JonBuhl/Hapticpad/3D Files/STEP/Custom Keycap - Machined.STEP

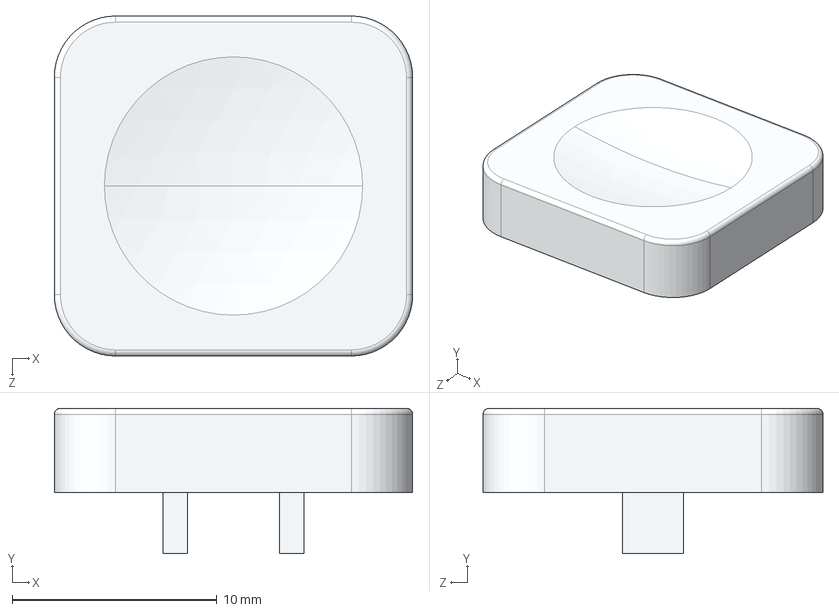
[picture p3: CAD file, 2026-01-09]
3D Files/STEP/Custom Keycap - Machined.STEP
17.5 x 7.10 x 16.6 mm
