JonBuhl/Hapticpad/3D Files/STL's/PCB Spacer.STL

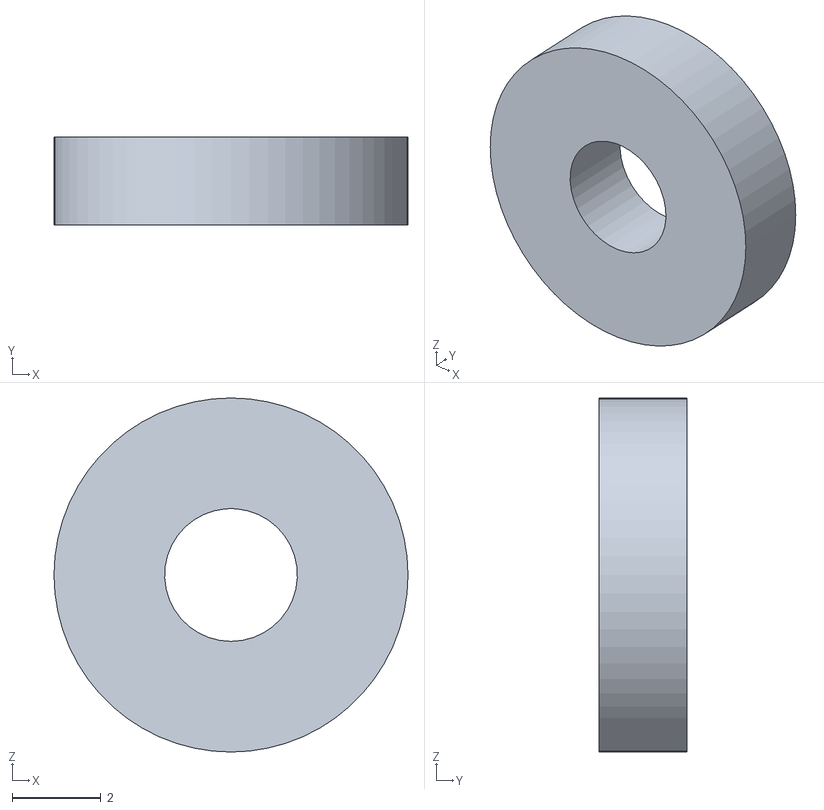
[picture p4: CAD file, 2026-01-09]
3D Files/STL's/PCB Spacer.STL
8.00 x 2.00 x 8.00
