JonBuhl/Hapticpad/3D Files/STEP/Macro Pad Jog Wheel Machined.STEP

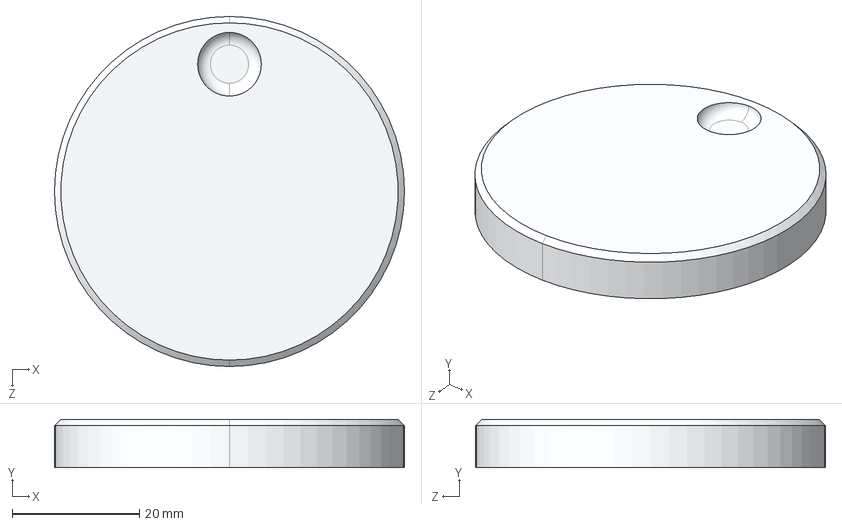
[picture p5: CAD file, 2026-01-09]
3D Files/STEP/Macro Pad Jog Wheel Machined.STEP
55.0 x 7.60 x 55.0 mm
