JonBuhl/Hapticpad/3D Files/STL's/Menu Button Printed.STL

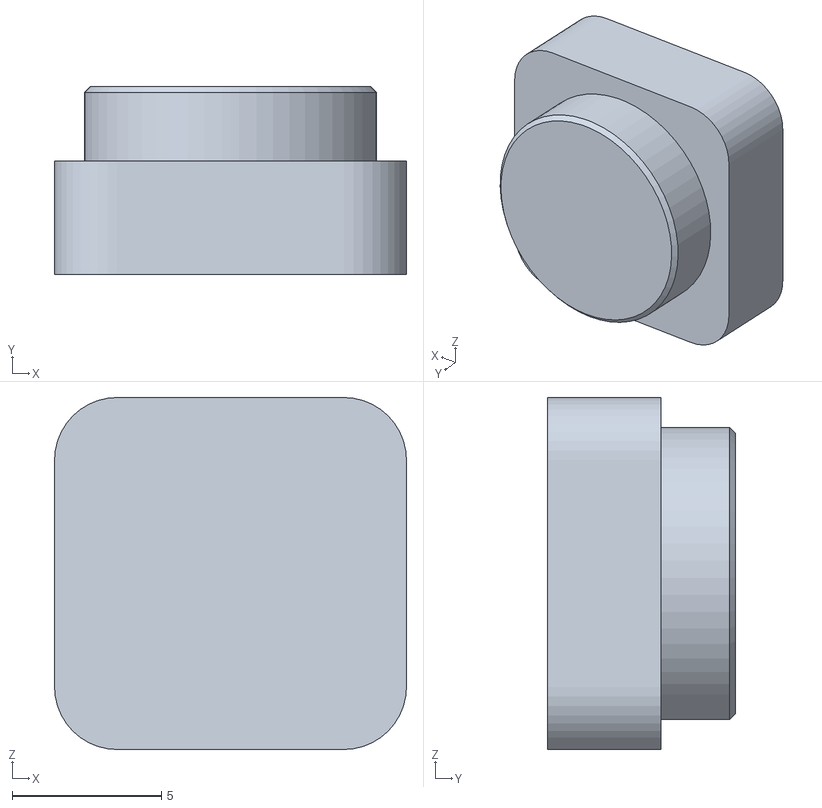
[picture p6: CAD file, 2026-01-09]
3D Files/STL's/Menu Button Printed.STL
11.8 x 6.30 x 11.8
