JonBuhl/Hapticpad/3D Files/STEP/Macro Pad Machined.STEP

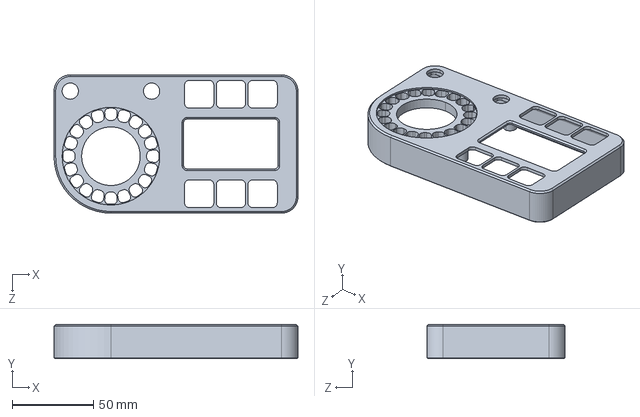
[picture p7: CAD file, 2026-01-09]
3D Files/STEP/Macro Pad Machined.STEP
150.0 x 21.0 x 85.0 mm
