JonBuhl/Hapticpad/3D Files/STL's/Macropad Bottom Cover.STL

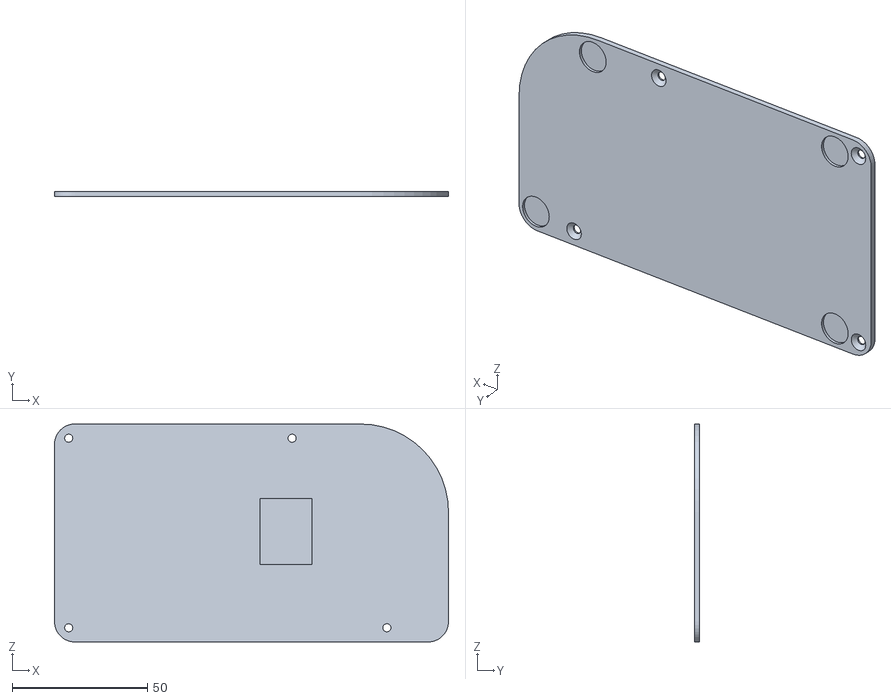
[picture p8: CAD file, 2026-01-09]
3D Files/STL's/Macropad Bottom Cover.STL
145.5 x 2.00 x 80.5
