JonBuhl/Hapticpad/3D Files/STL's/Encoder Mount.STL

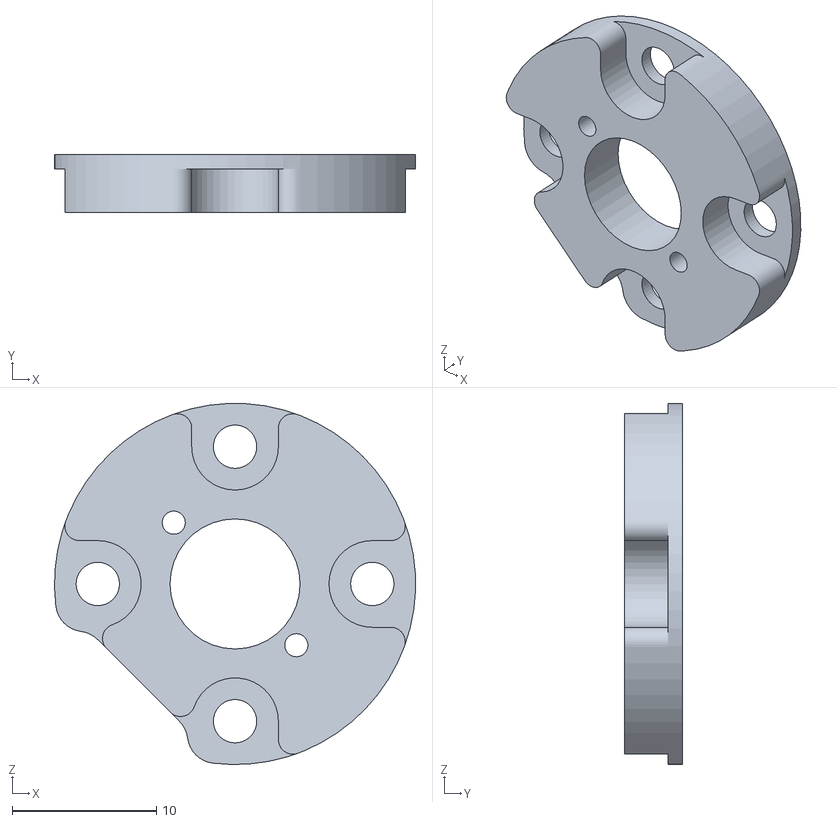
[picture p9: CAD file, 2026-01-09]
3D Files/STL's/Encoder Mount.STL
25.0 x 4.00 x 25.0
