JonBuhl/Hapticpad/3D Files/STL's/Magnet Wheel Mount.STL

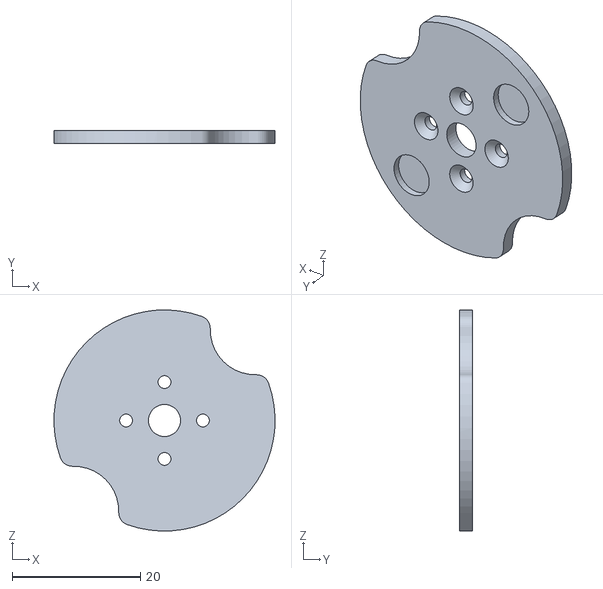
[picture p10: CAD file, 2026-01-09]
3D Files/STL's/Magnet Wheel Mount.STL
34.5 x 2.00 x 34.5
