JonBuhl/Hapticpad/3D Files/STL's/Magnet Holder.STL

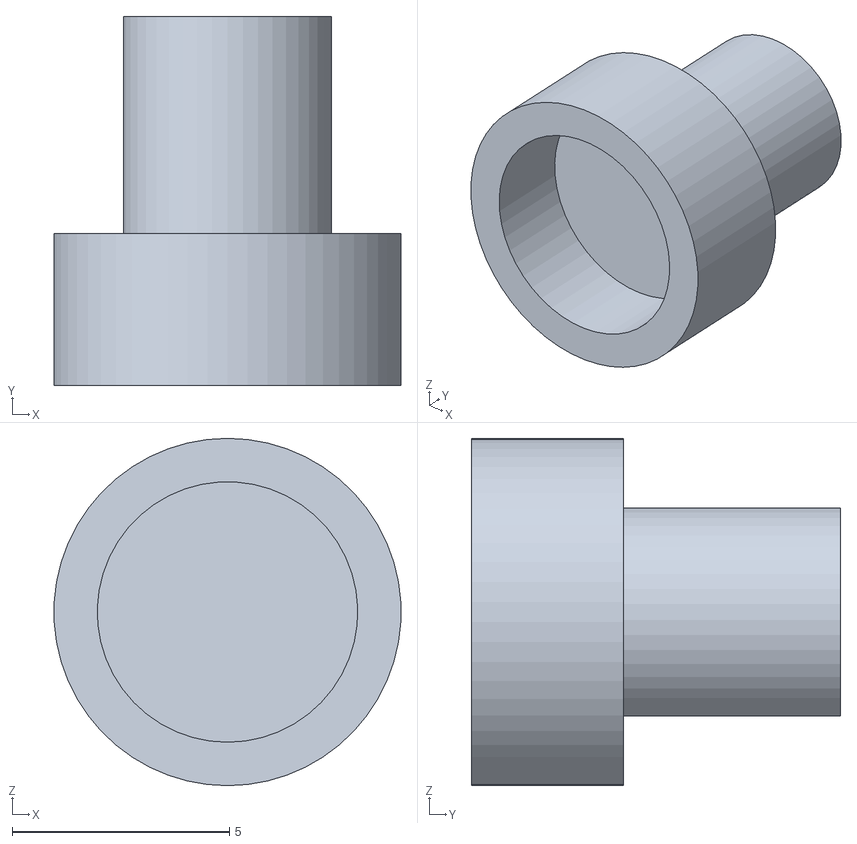
[picture p11: CAD file, 2026-01-09]
3D Files/STL's/Magnet Holder.STL
7.99 x 8.50 x 8.00
