JonBuhl/Hapticpad/3D Files/STL's/Macro Pad Magnetic Jog Wheel.STL

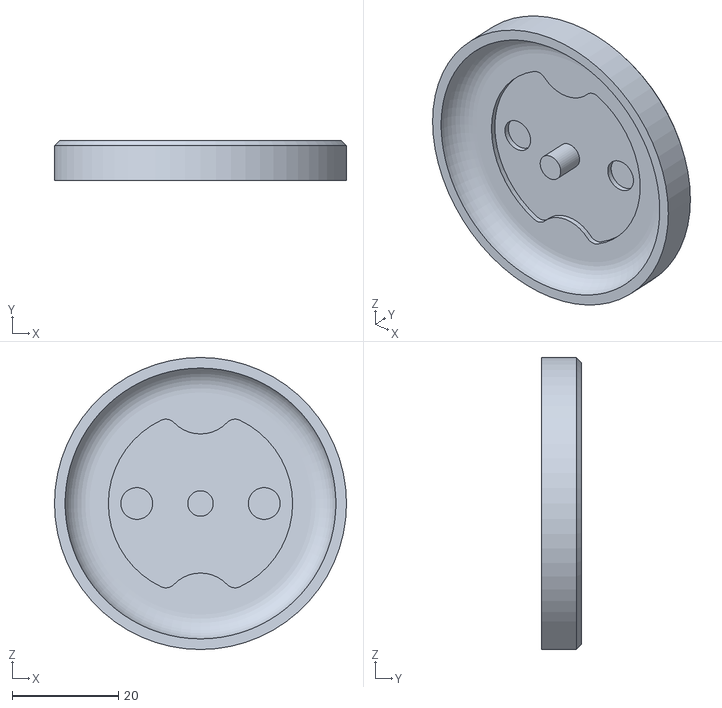
[picture p12: CAD file, 2026-01-09]
3D Files/STL's/Macro Pad Magnetic Jog Wheel.STL
55.0 x 7.60 x 55.0
