JonBuhl/Hapticpad/3D Files/STL's/LED Diffuser Ring.STL

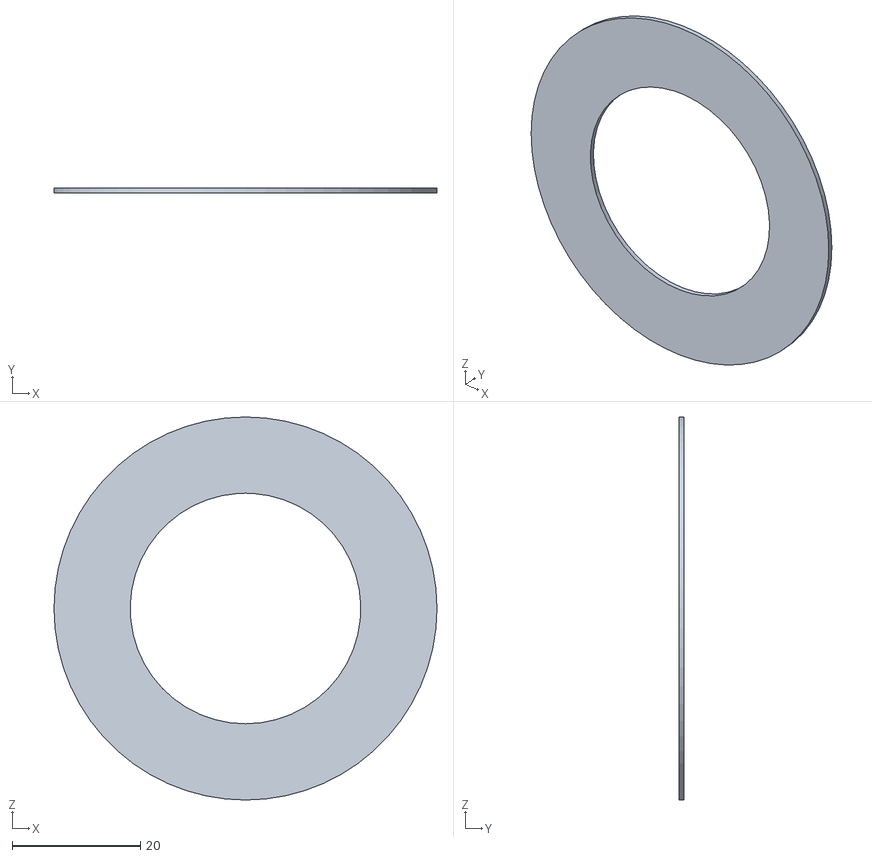
[picture p13: CAD file, 2026-01-09]
3D Files/STL's/LED Diffuser Ring.STL
59.8 x 0.8 x 59.8
