JonBuhl/Hapticpad/(list of files, cad)

Other CAD files:
3D Files/STEP/Menu Button - Machined.STEP
3D Files/STL's/Custom Keycap.STL
3D Files/STL's/Macro Pad - Printed Version.STL
