JonBuhl/Hapticpad/3D Files/STEP/Macro Pad Housing.pdf

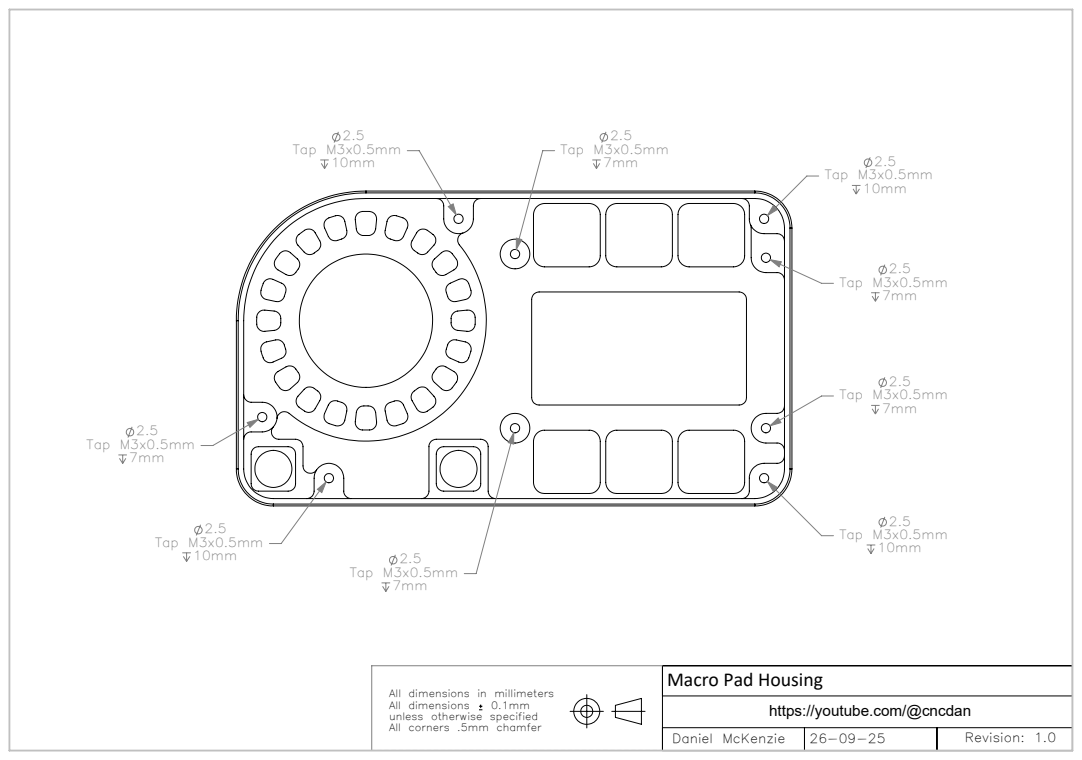
[picture p14: page 1]
Tap M3x0.5mm; Daniel McKenzie; Revision: 1.0; All dimensions

Macro Pad Housing

All dimensions in millimeters
unless otherwise specified
All corners .5mm chamfer

https://youtube.com/@cncdan
