JonBuhl/Hapticpad/PCB's/MacroPad Controller Board/MacroPad Controller Board.kicad_pcb

## KiCad design PCB's/MacroPad Controller Board/MacroPad Controller Board.kicad_pcb (2026-01-10)

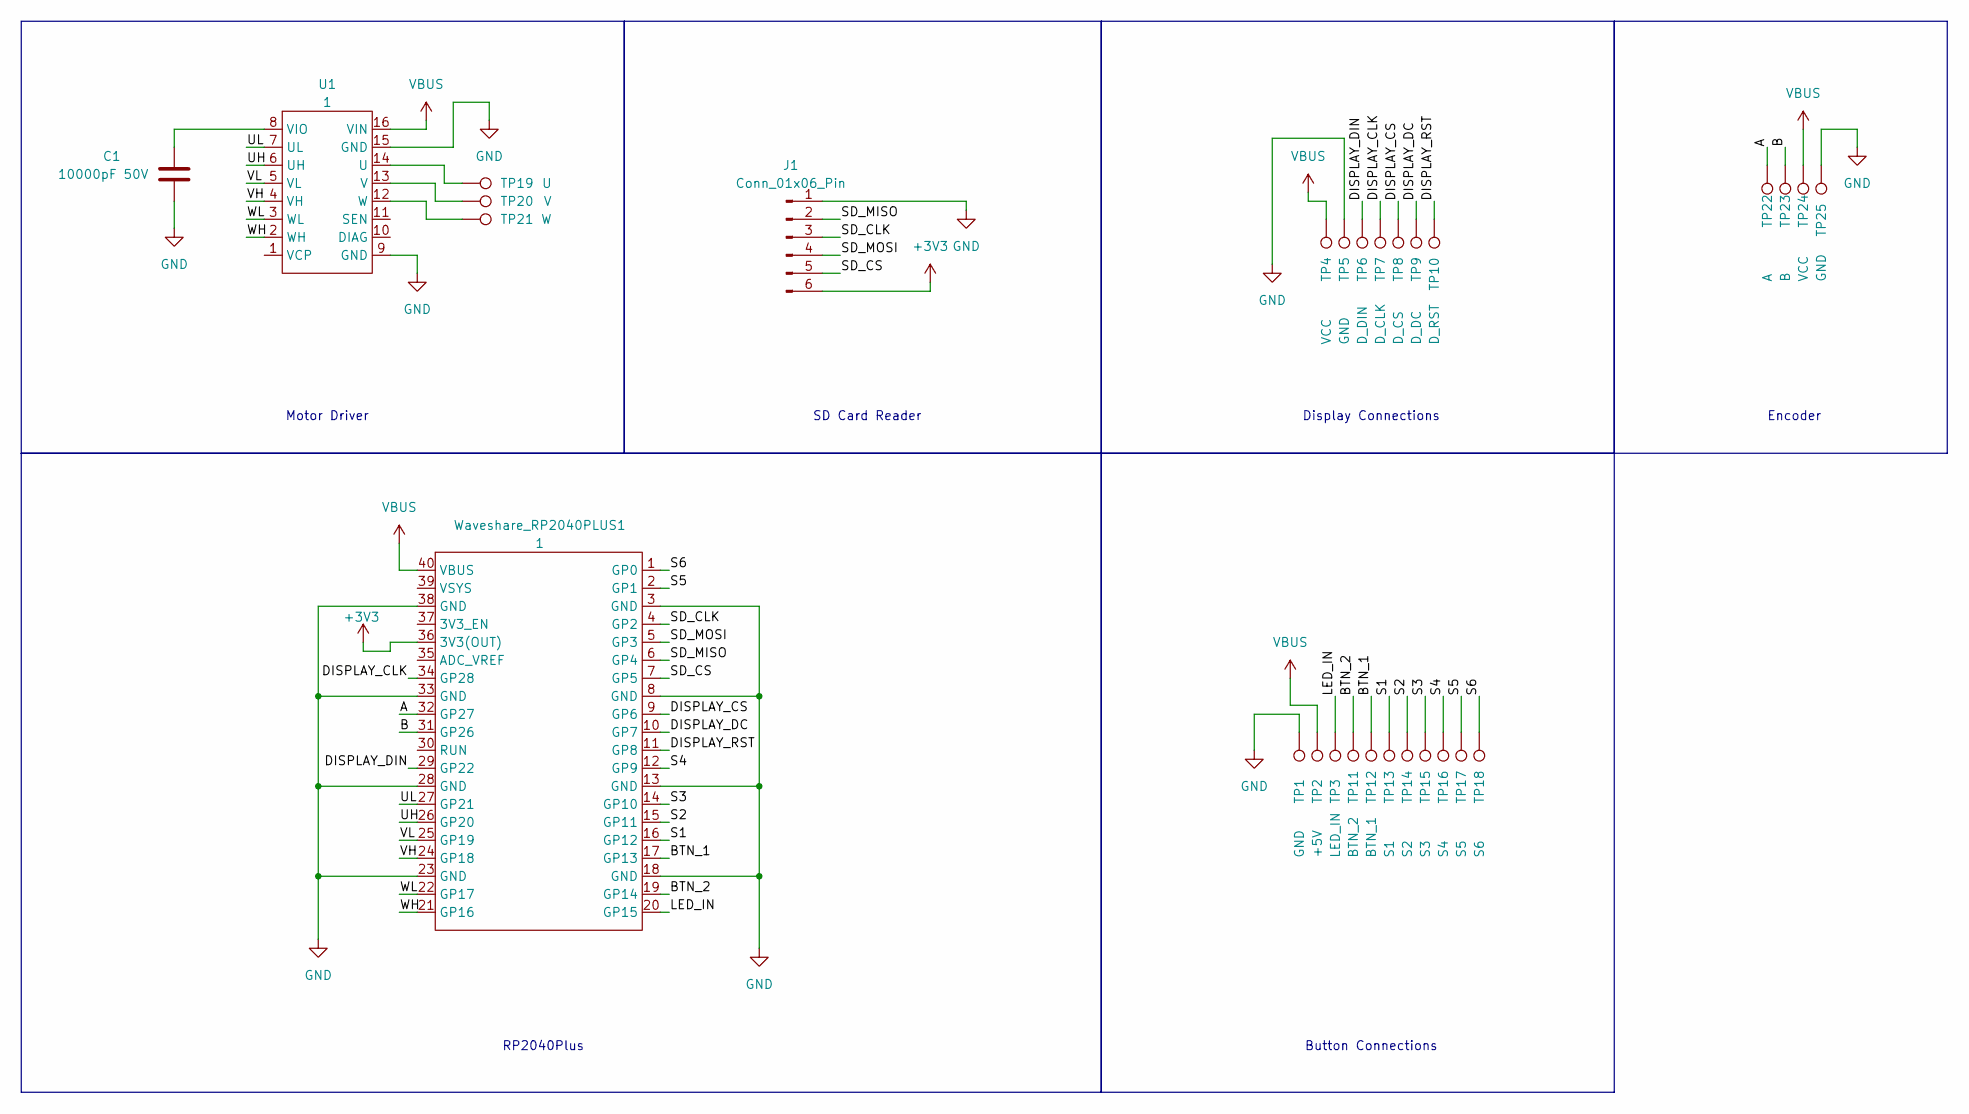
[picture p15: schematic MacroPad Controller Board.kicad_sch]

Parts:
C1: 10000pF 50V; C_0603_1608Metric_Pad1.08x0.95mm_HandSolder
J1: Conn_01x06_Pin; PinHeader_1x06_P2.54mm_Vertical
TP1, TP5, TP25: GND; TestPoint_THTPad_D1.0mm_Drill0.5mm
TP2: +5V; TestPoint_THTPad_D1.0mm_Drill0.5mm
TP3: LED_IN; TestPoint_THTPad_D1.0mm_Drill0.5mm
TP4, TP24: VCC; TestPoint_THTPad_D1.0mm_Drill0.5mm
TP6: D_DIN; TestPoint_THTPad_D1.0mm_Drill0.5mm
TP7: D_CLK; TestPoint_THTPad_D1.0mm_Drill0.5mm
TP8: D_CS; TestPoint_THTPad_D1.0mm_Drill0.5mm
TP9: D_DC; TestPoint_THTPad_D1.0mm_Drill0.5mm
TP10: D_RST; TestPoint_THTPad_D1.0mm_Drill0.5mm
TP11: BTN_2; TestPoint_THTPad_D1.0mm_Drill0.5mm
TP12: BTN_1; TestPoint_THTPad_D1.0mm_Drill0.5mm
TP13: S1; TestPoint_THTPad_D1.0mm_Drill0.5mm
TP14: S2; TestPoint_THTPad_D1.0mm_Drill0.5mm
TP15: S3; TestPoint_THTPad_D1.0mm_Drill0.5mm
TP16: S4; TestPoint_THTPad_D1.0mm_Drill0.5mm
TP17: S5; TestPoint_THTPad_D1.0mm_Drill0.5mm
TP18: S6; TestPoint_THTPad_D1.0mm_Drill0.5mm
TP19: U; TestPoint_THTPad_D2.0mm_Drill1.0mm
TP20: V; TestPoint_THTPad_D2.0mm_Drill1.0mm
TP21: W; TestPoint_THTPad_D2.0mm_Drill1.0mm
TP22: A; TestPoint_THTPad_D1.0mm_Drill0.5mm
TP23: B; TestPoint_THTPad_D1.0mm_Drill0.5mm
U1: 1; Sparkfun_TMC6300
Waveshare_RP2040PLUS1: 1; RP2040PLUS_SMD

Connections:
+3V3: J1.6, Waveshare_RP2040PLUS1.36 (3V3(OUT)); also elsewhere on the board
/A: TP22.1, Waveshare_RP2040PLUS1.32 (GP27); also elsewhere on the board
/B: TP23.1, Waveshare_RP2040PLUS1.31 (GP26); also elsewhere on the board
/BTN_1: TP12.1, Waveshare_RP2040PLUS1.17 (GP13); also elsewhere on the board
/BTN_2: TP11.1, Waveshare_RP2040PLUS1.19 (GP14); also elsewhere on the board
/DISPLAY_CLK: TP7.1, Waveshare_RP2040PLUS1.34 (GP28); also elsewhere on the board
/DISPLAY_CS: TP8.1, Waveshare_RP2040PLUS1.9 (GP6); also elsewhere on the board
/DISPLAY_DC: TP9.1, Waveshare_RP2040PLUS1.10 (GP7); also elsewhere on the board
/DISPLAY_DIN: TP6.1, Waveshare_RP2040PLUS1.29 (GP22); also elsewhere on the board
/DISPLAY_RST: TP10.1, Waveshare_RP2040PLUS1.11 (GP8); also elsewhere on the board
/LED_IN: TP3.1, Waveshare_RP2040PLUS1.20 (GP15); also elsewhere on the board
/S1: TP13.1, Waveshare_RP2040PLUS1.16 (GP12); also elsewhere on the board
/S2: TP14.1, Waveshare_RP2040PLUS1.15 (GP11); also elsewhere on the board
/S3: TP15.1, Waveshare_RP2040PLUS1.14 (GP10); also elsewhere on the board
/S4: TP16.1, Waveshare_RP2040PLUS1.12 (GP9); also elsewhere on the board
/S5: TP17.1, Waveshare_RP2040PLUS1.2 (GP1); also elsewhere on the board
/S6: TP18.1, Waveshare_RP2040PLUS1.1 (GP0); also elsewhere on the board
/SD_CLK: J1.3, Waveshare_RP2040PLUS1.4 (GP2); also elsewhere on the board
/SD_CS: J1.5, Waveshare_RP2040PLUS1.7 (GP5); also elsewhere on the board
/SD_MISO: J1.2, Waveshare_RP2040PLUS1.6 (GP4); also elsewhere on the board
/SD_MOSI: J1.4, Waveshare_RP2040PLUS1.5 (GP3); also elsewhere on the board
/UH: U1.6 (UH), Waveshare_RP2040PLUS1.26 (GP20); also elsewhere on the board
/UL: U1.7 (UL), Waveshare_RP2040PLUS1.27 (GP21); also elsewhere on the board
/VH: U1.4 (VH), Waveshare_RP2040PLUS1.24 (GP18); also elsewhere on the board
/VL: U1.5 (VL), Waveshare_RP2040PLUS1.25 (GP19); also elsewhere on the board
/WH: U1.2 (WH), Waveshare_RP2040PLUS1.21 (GP16); also elsewhere on the board
/WL: U1.3 (WL), Waveshare_RP2040PLUS1.22 (GP17); also elsewhere on the board
GND: C1.2, J1.1, TP1.1, TP5.1, TP25.1, U1.9 (GND), U1.15 (GND), Waveshare_RP2040PLUS1.3 (GND), Waveshare_RP2040PLUS1.8 (GND), Waveshare_RP2040PLUS1.13 (GND), Waveshare_RP2040PLUS1.18 (GND), Waveshare_RP2040PLUS1.23 (GND), Waveshare_RP2040PLUS1.28 (GND), Waveshare_RP2040PLUS1.33 (GND), Waveshare_RP2040PLUS1.38 (GND); also elsewhere on the board
unnamed: TP19.1, U1.14 (U)
unnamed: TP20.1, U1.13 (V)
unnamed: C1.1, U1.8 (VIO)
unnamed: TP21.1, U1.12 (W)
VBUS: TP2.1, TP4.1, TP24.1, U1.16 (VIN), Waveshare_RP2040PLUS1.40 (VBUS); also elsewhere on the board

Notes on the sheet:
Motor Driver
SD Card Reader
RP2040Plus
Display Connections
Button Connections
Encoder

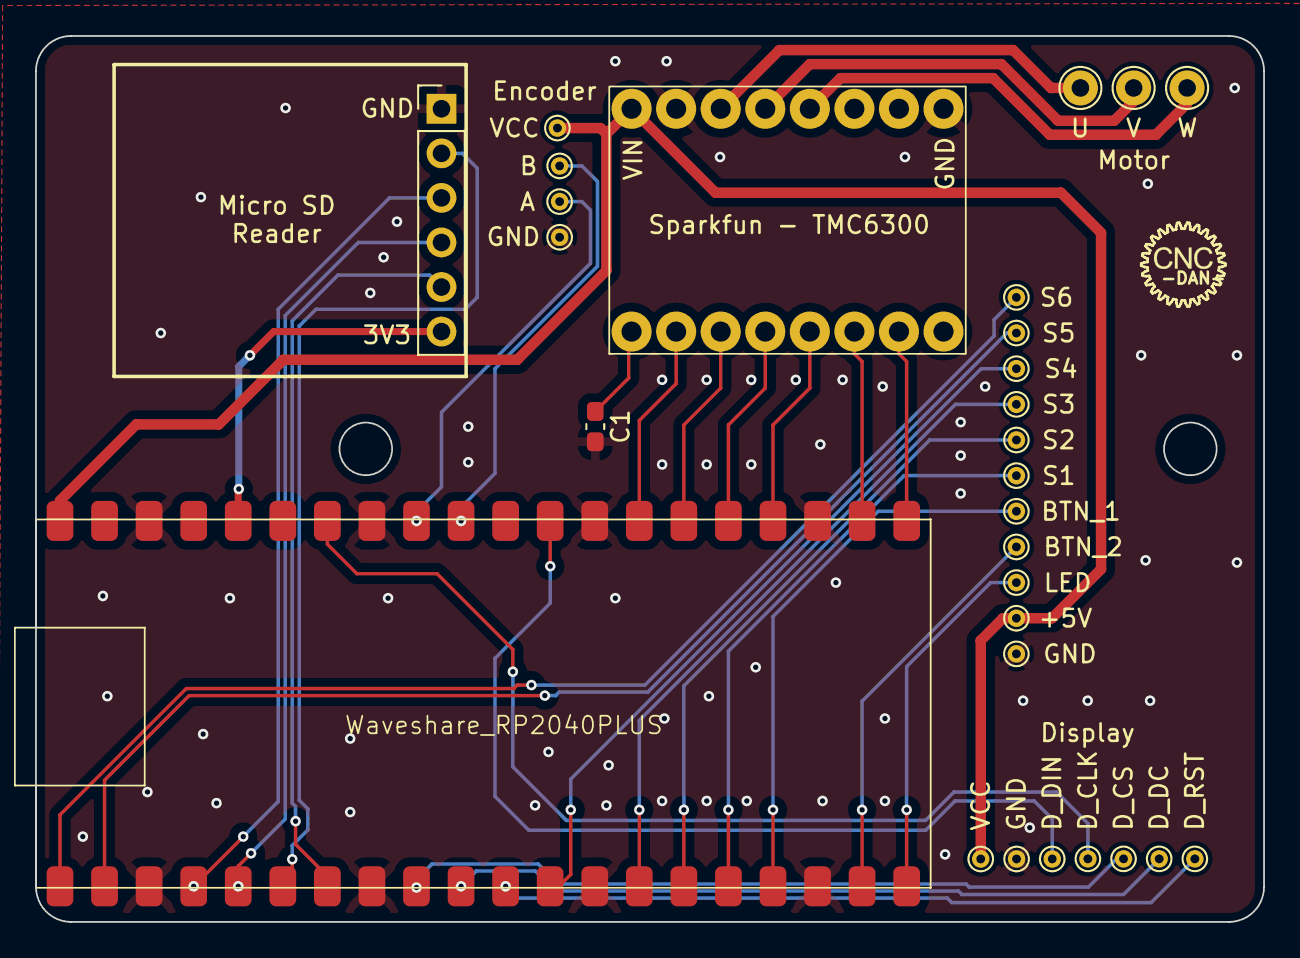
[picture p16: board MacroPad Controller Board.kicad_pcb from above]

Board: 2 copper layers, 70.0 x 50.5 mm, 29 parts (0 on the bottom side), 33 nets.

Other parts of the board:
Waveshare_RP2040PLUS: 1; RP2040PLUS_SMD

Their connections:
+3V3: Waveshare_RP2040PLUS.36 (3V3(OUT)); also elsewhere on the board
/A: Waveshare_RP2040PLUS.32 (GP27); also elsewhere on the board
/B: Waveshare_RP2040PLUS.31 (GP26); also elsewhere on the board
/BTN_1: Waveshare_RP2040PLUS.17 (GP13); also elsewhere on the board
/BTN_2: Waveshare_RP2040PLUS.19 (GP14); also elsewhere on the board
/DISPLAY_CLK: Waveshare_RP2040PLUS.34 (GP28); also elsewhere on the board
/DISPLAY_CS: Waveshare_RP2040PLUS.9 (GP6); also elsewhere on the board
/DISPLAY_DC: Waveshare_RP2040PLUS.10 (GP7); also elsewhere on the board
/DISPLAY_DIN: Waveshare_RP2040PLUS.29 (GP22); also elsewhere on the board
/DISPLAY_RST: Waveshare_RP2040PLUS.11 (GP8); also elsewhere on the board
/LED_IN: Waveshare_RP2040PLUS.20 (GP15); also elsewhere on the board
/S1: Waveshare_RP2040PLUS.16 (GP12); also elsewhere on the board
/S2: Waveshare_RP2040PLUS.15 (GP11); also elsewhere on the board
/S3: Waveshare_RP2040PLUS.14 (GP10); also elsewhere on the board
/S4: Waveshare_RP2040PLUS.12 (GP9); also elsewhere on the board
/S5: Waveshare_RP2040PLUS.2 (GP1); also elsewhere on the board
/S6: Waveshare_RP2040PLUS.1 (GP0); also elsewhere on the board
/SD_CLK: Waveshare_RP2040PLUS.4 (GP2); also elsewhere on the board
/SD_CS: Waveshare_RP2040PLUS.7 (GP5); also elsewhere on the board
/SD_MISO: Waveshare_RP2040PLUS.6 (GP4); also elsewhere on the board
/SD_MOSI: Waveshare_RP2040PLUS.5 (GP3); also elsewhere on the board
/UH: Waveshare_RP2040PLUS.26 (GP20); also elsewhere on the board
/UL: Waveshare_RP2040PLUS.27 (GP21); also elsewhere on the board
/VH: Waveshare_RP2040PLUS.24 (GP18); also elsewhere on the board
/VL: Waveshare_RP2040PLUS.25 (GP19); also elsewhere on the board
/WH: Waveshare_RP2040PLUS.21 (GP16); also elsewhere on the board
/WL: Waveshare_RP2040PLUS.22 (GP17); also elsewhere on the board
GND: Waveshare_RP2040PLUS.3 (GND), Waveshare_RP2040PLUS.8 (GND), Waveshare_RP2040PLUS.13 (GND), Waveshare_RP2040PLUS.18 (GND), Waveshare_RP2040PLUS.23 (GND), Waveshare_RP2040PLUS.28 (GND), Waveshare_RP2040PLUS.33 (GND), Waveshare_RP2040PLUS.38 (GND); also elsewhere on the board
VBUS: Waveshare_RP2040PLUS.40 (VBUS); also elsewhere on the board
