JonBuhl/Hapticpad/PCB's/MacroPad/MacroPad.kicad_pcb

## KiCad design PCB's/MacroPad/MacroPad.kicad_pcb (2026-01-10)

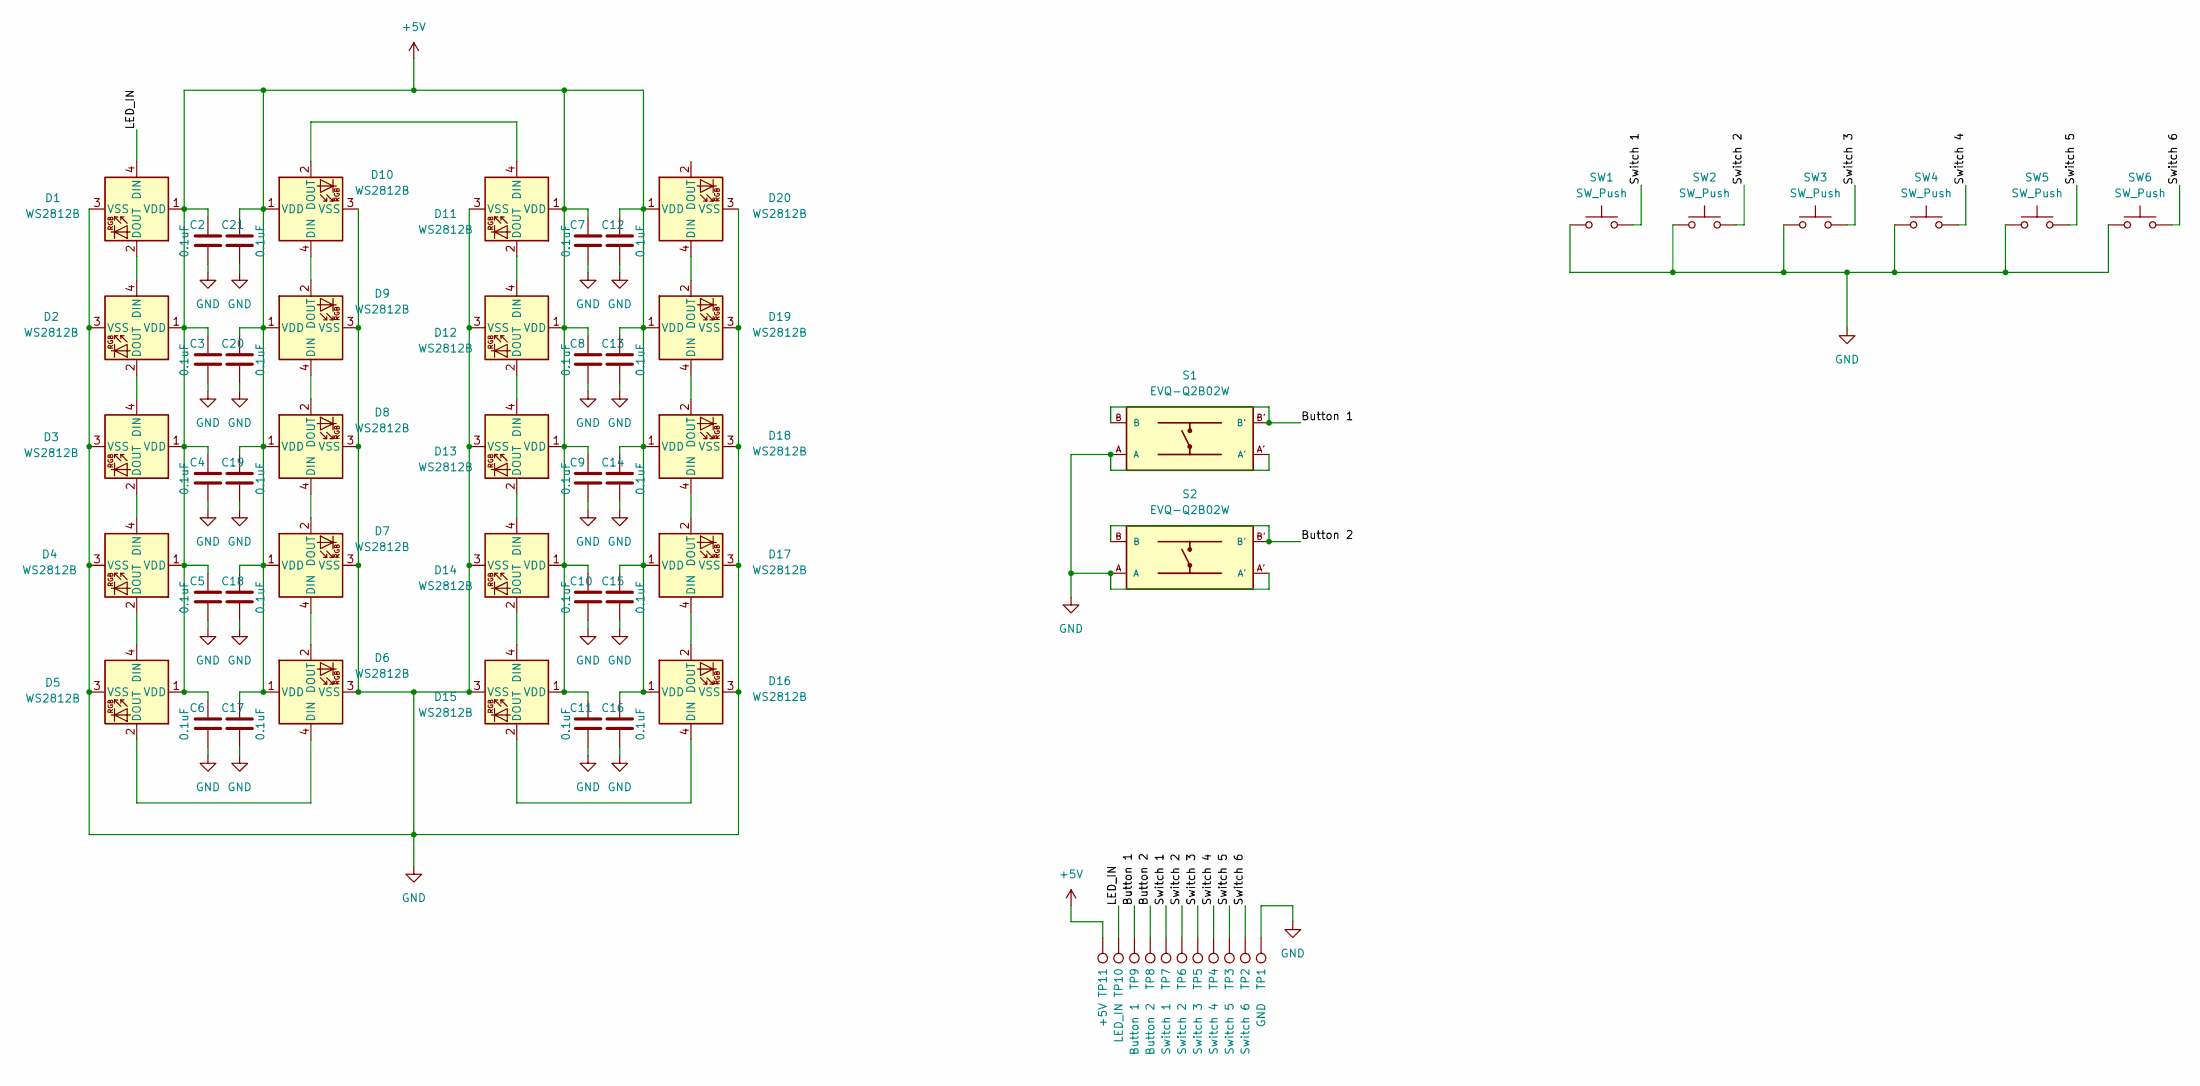
[picture p17: schematic MacroPad.kicad_sch]

Parts:
C2, C3, C4, C5, C6, C7, C8, C9, C10, C11, C12, C13, C14, C15, C16, C17, C18, C19, C20, C21: 0.1uF; C_0603_1608Metric
D1, D2, D3, D4, D5, D6, D7, D8, D9, D10, D11, D12, D13, D14, D15, D16, D17, D18, D19, D20: WS2812B; LED_WS2812B_PLCC4_5.0x5.0mm_P3.2mm
S1, S2: EVQ-Q2B02W; SW_EVQ-Q2B02W
SW1, SW2, SW3, SW4, SW5, SW6: SW_Push; SW_PG1350_reversible
TP1: GND; TestPoint_THTPad_D1.0mm_Drill0.5mm
TP2: Switch 6; TestPoint_THTPad_D1.0mm_Drill0.5mm
TP3: Switch 5; TestPoint_THTPad_D1.0mm_Drill0.5mm
TP4: Switch 4; TestPoint_THTPad_D1.0mm_Drill0.5mm
TP5: Switch 3; TestPoint_THTPad_D1.0mm_Drill0.5mm
TP6: Switch 2; TestPoint_THTPad_D1.0mm_Drill0.5mm
TP7: Switch 1; TestPoint_THTPad_D1.0mm_Drill0.5mm
TP8: Button 2; TestPoint_THTPad_D1.0mm_Drill0.5mm
TP9: Button 1; TestPoint_THTPad_D1.0mm_Drill0.5mm
TP10: LED_IN; TestPoint_THTPad_D1.0mm_Drill0.5mm
TP11: +5V; TestPoint_THTPad_D1.0mm_Drill0.5mm

Connections:
+5V: C2.1, C3.1, C4.1, C5.1, C6.1, C7.1, C8.1, C9.1, C10.1, C11.1, C12.1, C13.1, C14.1, C15.1, C16.1, C17.1, C18.1, C19.1, C20.1, C21.1, D1.1 (VDD), D2.1 (VDD), D3.1 (VDD), D4.1 (VDD), D5.1 (VDD), D6.1 (VDD), D7.1 (VDD), D8.1 (VDD), D9.1 (VDD), D10.1 (VDD), D11.1 (VDD), D12.1 (VDD), D13.1 (VDD), D14.1 (VDD), D15.1 (VDD), D16.1 (VDD), D17.1 (VDD), D18.1 (VDD), D19.1 (VDD), D20.1 (VDD), TP11.1
/Button 1: S1.B, S1.B', TP9.1
/Button 2: S2.B, S2.B', TP8.1
/LED_IN: D1.4 (DIN), TP10.1
/Switch 1: SW1.2, TP7.1
/Switch 2: SW2.2, TP6.1
/Switch 3: SW3.2, TP5.1
/Switch 4: SW4.2, TP4.1
/Switch 5: SW5.2, TP3.1
/Switch 6: SW6.2, TP2.1
GND: C2.2, C3.2, C4.2, C5.2, C6.2, C7.2, C8.2, C9.2, C10.2, C11.2, C12.2, C13.2, C14.2, C15.2, C16.2, C17.2, C18.2, C19.2, C20.2, C21.2, D1.3 (VSS), D2.3 (VSS), D3.3 (VSS), D4.3 (VSS), D5.3 (VSS), D6.3 (VSS), D7.3 (VSS), D8.3 (VSS), D9.3 (VSS), D10.3 (VSS), D11.3 (VSS), D12.3 (VSS), D13.3 (VSS), D14.3 (VSS), D15.3 (VSS), D16.3 (VSS), D17.3 (VSS), D18.3 (VSS), D19.3 (VSS), D20.3 (VSS), S1.A, S1.A', S2.A, S2.A', SW1.1, SW2.1, SW3.1, SW4.1, SW5.1, SW6.1, TP1.1
unnamed: D1.2 (DOUT), D2.4 (DIN)
unnamed: D2.2 (DOUT), D3.4 (DIN)
unnamed: D3.2 (DOUT), D4.4 (DIN)
unnamed: D4.2 (DOUT), D5.4 (DIN)
unnamed: D5.2 (DOUT), D6.4 (DIN)
unnamed: D6.2 (DOUT), D7.4 (DIN)
unnamed: D7.2 (DOUT), D8.4 (DIN)
unnamed: D8.2 (DOUT), D9.4 (DIN)
unnamed: D9.2 (DOUT), D10.4 (DIN)
unnamed: D10.2 (DOUT), D11.4 (DIN)
unnamed: D11.2 (DOUT), D12.4 (DIN)
unnamed: D12.2 (DOUT), D13.4 (DIN)
unnamed: D13.2 (DOUT), D14.4 (DIN)
unnamed: D14.2 (DOUT), D15.4 (DIN)
unnamed: D15.2 (DOUT), D16.4 (DIN)
unnamed: D16.2 (DOUT), D17.4 (DIN)
unnamed: D17.2 (DOUT), D18.4 (DIN)
unnamed: D18.2 (DOUT), D19.4 (DIN)
unnamed: D19.2 (DOUT), D20.4 (DIN)

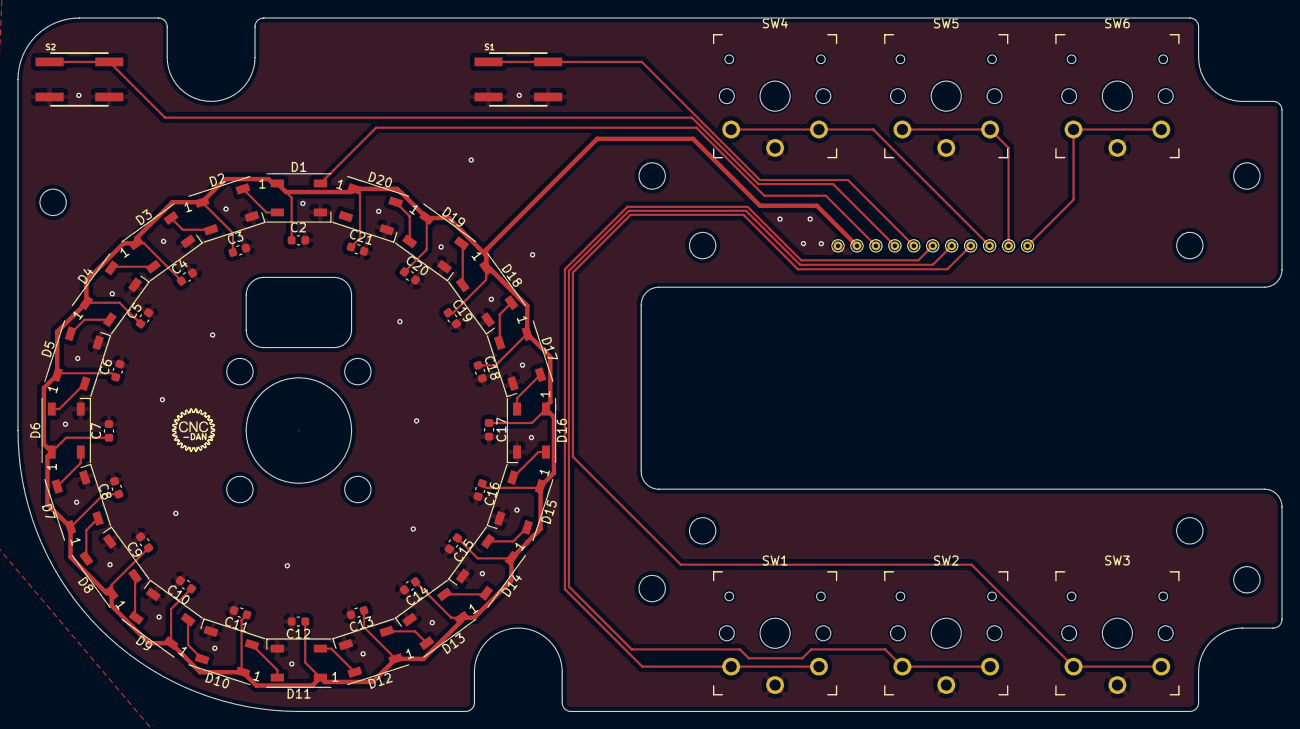
[picture p18: board MacroPad.kicad_pcb from above]

Board: 2 copper layers, 144.0 x 79.0 mm, 59 parts (0 on the bottom side), 30 nets.
