JonBuhl/Hapticpad/Software/MacroPad/MacroPad.ino

#include <Arduino.h>
#include <U8g2lib.h>
#include <SimpleFOC.h>
#include <Adafruit_TinyUSB.h>
#include <SdFat.h>
#include <SPI.h>
#include <SD.h>
#include <FastLED.h>
#include "menu.h"
#include "haptics.h"

const unsigned char SD_Card [] PROGMEM = {
	0xff, 0x01, 0x55, 0x01, 0x55, 0x01, 0xff, 0x01, 0x01, 0x03, 0x2d, 0x02, 0x45, 0x03, 0x49, 0x01, 
	0x2d, 0x03, 0x01, 0x02, 0xfd, 0x02, 0x01, 0x02, 0xff, 0x03
};

#ifdef U8X8_HAVE_HW_I2C
#include <Wire.h>
#endif

// Wheel mode ids and the haptic model live in haptics.h

#define KEY_LEFT_CTRL 17

#define NUM_LEDS 20
#define DATA_PIN 15

CRGB leds[NUM_LEDS];

//User Configurable LED Settings
byte primaryColour[3] = {0,50,50}; //Red, Green, Blue
byte secondaryColour[3] = {0,0,0};
int ledBrightness = 100;
int ledSpeed = 50;

//LED Sequence Variables
float redScale;
float greenScale;
float blueScale;
int sequenceStep = 0;
int ledMode = 3;
unsigned long ledTimer;

const uint8_t LED_MODE_COUNT = 6;
const char *ledModeNames[LED_MODE_COUNT] = {"Halo", "Breath", "Bands", "Rainbow", "Solid", "Off"};
uint8_t ledModeMenu[LED_MODE_COUNT] = {0, 1, 2, 3, 4, 5};
uint8_t ledModeMenuCount = LED_MODE_COUNT;
uint8_t rgbMenuSelection = 3;
uint8_t colorMenuSelection = 0;
uint8_t colorEditSelection = 0;
uint8_t colorEditChannel = 0; //0=R,1=G,2=B
bool colorEditActive = false;
uint8_t *colorEditPtr = nullptr;
bool colorDirty = false;

int8_t ledModeIndex(const char *mode) {
  if (strcmp(mode, "Halo") == 0) return 0;
  if (strcmp(mode, "Breath") == 0) return 1;
  if (strcmp(mode, "Bands") == 0) return 2;
  if (strcmp(mode, "Rainbow") == 0) return 3;
  if (strcmp(mode, "Solid") == 0) return 4;
  if (strcmp(mode, "Off") == 0) return 5;
  return -1;
}

const char *ledModeToString(uint8_t mode) {
  if (mode < LED_MODE_COUNT) {
    return ledModeNames[mode];
  }
  return "";
}

uint8_t findLedMenuIndex(uint8_t mode){
  for(uint8_t i = 0; i < ledModeMenuCount; i++){
    if(ledModeMenu[i] == mode){
      return i;
    }
  }
  return 0;
}

//LED Halo Variables
int haloCount = 0; //Which is the brightest LED in the sequence

//LED Breath Variables
bool breathIncrease = true;

//LED Bands
bool evenNumber = false;
int loopCounter;

bool debug = false;

//SD Pins
const int _MISO = 4;
const int _MOSI = 3;
const int _CS = 5;
const int _SCK = 2;

bool sdDetected = false;

Adafruit_USBD_MSC usb_msc;
SdFat usbStorageFat;
SdSpiConfig usbStorageConfig(_CS, DEDICATED_SPI, SD_SCK_MHZ(12), &SPI);
uint32_t usbStorageBlockCount = 0;
bool usbStorageMode = false;
unsigned long usbStorageButtonTimer = 0;

U8G2_SSD1309_128X64_NONAME0_1_4W_SW_SPI u8g2(U8G2_R0, 28, 22, 6, 7, 8);

BLDCMotor motor = BLDCMotor(7);
BLDCDriver6PWM driver = BLDCDriver6PWM(20, 21, 18,19, 16, 17);

//float target_velocity = 6;
Commander command = Commander(Serial);

Encoder encoder = Encoder(27, 26, 1024);
void doA(){encoder.handleA();}
void doB(){encoder.handleB();}

// angle set point variable
float target_angle = 0; //Radians. 1 Rad = 57.2958 Deg
float new_target_angle;

float target_velocity = 0;
float last_velocity = 0;
float testFactor;

float angle_step = radians(360/40);
float encoderAngle;
float lastEncoderAngle;
bool keyPressed = false;
bool wheelKeyPressed = false;

//PID Values

float Clicky_P = 0.5;    //legacy, Clicky now uses the haptic model
float Clicky_I = 0;      //legacy
float Twist_P = 0.65;    //legacy, Twist now uses the haptic model
float Twist_I = 0.2;     //legacy
float Momentum_P = 0.3;
float Momentum_I = 0;
float motorP = 0.5;
float motorI = 0;
float motorD = 0;

long timer;
long aceltimer;
long mouseTimer;
float interval;
unsigned long wheelKeyTimer;
unsigned long keyTimer;

long debounceTimer;
bool decelDetected = false;
bool decelerating = false;

// wheelMode and wheelModeChanged are written on core 1 (profile/settings load,
// opening and closing the menu) and read on core 0 in loop(). Without volatile
// the compiler is free to hoist the load out of the main loop, which leaves core
// 0 running whichever mode it saw first and never noticing the menu.
volatile int wheelMode = 0;
int lastWheelMode = -1; //core 0 only
volatile bool wheelModeChanged = true;

// ---- Wheel domains ----
// A macro button that carries a <WheelMode> of its own replaces what the wheel
// does while it is selected, instead of sending a macro. wheelMode above always
// holds whatever is currently driving the wheel; these two keep the profile's
// own settings so we can fall back to them, and so lastState never records a
// domain mode.
uint8_t profileWheelMode = 0;
uint8_t profileWheelKey = 0;
// Per button domain settings, WHEEL_DOMAIN_NONE = ordinary macro button. Note
// that WHEEL_DOMAIN_NONE is not zero, so these cannot be left to zero init or
// every button would look like a Clicky domain until a profile is loaded.
uint8_t buttonWheelMode[6] = {
  WHEEL_DOMAIN_NONE, WHEEL_DOMAIN_NONE, WHEEL_DOMAIN_NONE,
  WHEEL_DOMAIN_NONE, WHEEL_DOMAIN_NONE, WHEEL_DOMAIN_NONE
};
uint8_t buttonWheelUp[6];
uint8_t buttonWheelDown[6];
// Pseudo keycode for a direction action. It is not a key and must never reach
// convertKeycode() or convertConsumerKeycode(), which is why it sits in the gap
// between the consumer codes (173-205) and the punctuation ones (219-222) that
// keyCodes.ino uses. A domain carrying it reports its detents to the host over
// the serial port instead of pressing anything, see serialScratchTick().
#define WHEEL_KEY_SERIAL_SCRATCH 250
// Written on core 1 by the button handler, read on core 0 in wheelScrollOutput()
// and on core 1 by the display. Must be volatile, see wheelMode above.
volatile int8_t activeWheelDomain = -1; //-1 = profile default

bool FOC_Ready = false;

#define buttonCount 8 //Number of buttons connected
byte buttonPins[buttonCount] = {9, 1, 0, 12, 11, 10, 13, 14}; //1,2,3,4,5,6
// The debounced state everything else works from. Sampled by buttonDebounce()
// on core 0 and read on core 1, so it has to be volatile, see wheelMode above.
volatile int lastButtonState[buttonCount];
// Raw pin readings and the moment each one last changed, used to fold the
// contact bounce out before it ever reaches lastButtonState.
int buttonRawState[buttonCount];
unsigned long buttonDebounceTimer[buttonCount];
// Core 0 is running loop() well before core 1 has configured the pull ups, and
// a floating input reads as a pressed button. Sampling waits for this.
volatile bool buttonsReady = false;
// How long a reading has to hold still before it counts as the button's state.
// Comfortably longer than the few milliseconds a tact switch chatters for on
// either edge, and short enough to stay invisible at any speed a finger can
// manage.
#define BUTTON_DEBOUNCE_MS 25

// ---- Smart sleep ----
// Idle timeout after which the OLED and the LED ring are switched off, see
// sleep.ino. Configurable through <Sleep_Timeout> in config.xml, 0 turns the
// whole thing off.
#define SLEEP_DEFAULT_TIMEOUT_MIN 5
#define SLEEP_MAX_TIMEOUT_MIN 240
// Radians of wheel travel that count as the user doing something, roughly a
// degree. Well above the odd count of quadrature chatter.
#define SLEEP_WHEEL_DEADBAND 0.02f
uint16_t sleepTimeoutMinutes = SLEEP_DEFAULT_TIMEOUT_MIN;
// Set on core 1 by enterSleep()/wakeFromSleep() and read on core 0 in
// buttonDebounce(), so volatile for the same reason lastButtonState is.
volatile bool sleepActive = false;
// A press edge seen by core 0 while the pad is asleep. Core 1 acts on it and
// clears it. Without this a short tap could fall between two core 1 frames and
// leave the pad dark.
volatile bool sleepWakeRequest = false;
// Swallows the press that did the waking, cleared once everything is released.
bool sleepWakeGuard = false;
// Written by both cores, read on core 1. A plain 32 bit store, see
// noteActivity().
volatile unsigned long lastActivityTime = 0;

//Eeprom Memory
int activeProfile = 0;
//int activePage = 1;

uint8_t icon1[15][2]; //Used to store Icon 1 Data
uint8_t icon2[15][2]; //Used to store Icon 2 Data
uint8_t icon3[15][2]; //Used to store Icon 3 Data
uint8_t icon4[15][2]; //Used to store Icon 4 Data
uint8_t icon5[15][2]; //Used to store Icon 5 Data
uint8_t icon6[15][2]; //Used to store Icon 6 Data

// ---- Profile data ----
#define maxProfileNameLength 32
#define maxProfiles 256
char profileName[maxProfileNameLength];
char profileNames[maxProfileNameLength][maxProfiles];
char buttonLabel[6][32];
unsigned long profileChangeTimer;
bool profilePlusStarted = false;
bool profileMinusStarted = false;
// Set on core 1, read on core 0 to decide whether the wheel drives the menu or
// the PC. Must be volatile, see wheelMode above.
volatile bool profileSelectMenu = false;

enum MenuPage : uint8_t {
  MENU_NONE = 0,
  MENU_ROOT,
  MENU_PROFILE,
  MENU_RGB,
  MENU_COLOR,
  MENU_HAPTIC
};

volatile MenuPage menuPage = MENU_NONE;
uint8_t menuRootSelection = 0; //0 = Profile menu, 1 = RGB menu
uint8_t profileMenuSelection = 0;
bool menuReentryGuard = false; //prevents immediate re-entry after exit until buttons released

// Written on core 1 by enterMenu()/exitMenu(), read on core 0 by menuScroll().
const MenuDefinition * volatile currentMenu = nullptr;

void enterMenu(MenuPage page);
void exitMenu();
void applyProfileSelection(uint8_t selection);
void applyLedSelection(uint8_t selection);
bool enterUsbStorageMode();
void exitUsbStorageMode();
void toggleUsbStorageMode();
void setupUsbStorage();
void drawUsbStorageScreen();

unsigned long buttonPressStart[buttonCount];
// Both of these are cleared by buttonDebounce() on core 0 when the button is
// released and set on core 1 when the press has been acted on, so they are
// volatile for the same reason lastButtonState is.
volatile bool menuButtonHandled[buttonCount];
// Wheel domain buttons toggle on the press edge only, so holding one down does
// not keep flipping the domain.
volatile bool domainButtonHandled[6];
// Macro buttons fire on the press edge only, like the domain buttons. Without
// this a held button re-sent its macro on every display frame, so a single
// press of a toggle key like Play/Pause toggled several times.
volatile bool macroButtonHandled[6];

uint8_t wheelAction;
uint8_t macroAction[6][3];   // decimal values
uint16_t macroDelay[6][3];
float targetAngle;

// ---- Global ----
uint16_t totalProfiles = 0;

File root;

enum {
  REPORT_ID_KEYBOARD = 1,
  REPORT_ID_CONSUMER,
};

uint8_t const desc_hid_report[] =
{
  TUD_HID_REPORT_DESC_KEYBOARD(HID_REPORT_ID(REPORT_ID_KEYBOARD)),
  TUD_HID_REPORT_DESC_CONSUMER(HID_REPORT_ID(REPORT_ID_CONSUMER))
};

uint8_t const desc_mouse_report[] =
{
  TUD_HID_REPORT_DESC_MOUSE()
};

Adafruit_USBD_HID usb_keyboard(desc_hid_report, sizeof(desc_hid_report), HID_ITF_PROTOCOL_NONE, 2, false);
Adafruit_USBD_HID usb_mouse(desc_mouse_report, sizeof(desc_mouse_report), HID_ITF_PROTOCOL_MOUSE, 2, false);

int32_t usbStorageReadCb(uint32_t lba, void* buffer, uint32_t bufsize) {
  if(!usbStorageMode || usbStorageBlockCount == 0 || !usbStorageFat.card()){
    return -1;
  }

  uint32_t blockCount = bufsize / 512;
  return usbStorageFat.card()->readSectors(lba, static_cast<uint8_t*>(buffer), blockCount) ? (int32_t)bufsize : -1;
}

int32_t usbStorageWriteCb(uint32_t lba, uint8_t* buffer, uint32_t bufsize) {
  if(!usbStorageMode || usbStorageBlockCount == 0 || !usbStorageFat.card()){
    return -1;
  }

  uint32_t blockCount = bufsize / 512;
  return usbStorageFat.card()->writeSectors(lba, buffer, blockCount) ? (int32_t)bufsize : -1;
}

void usbStorageFlushCb(void) {
  if(!usbStorageMode || !usbStorageFat.card()){
    return;
  }

  usbStorageFat.card()->syncDevice();
}

void setup() { //Core 0
  // 50 kHz instead of the SimpleFOC default (~20 kHz): pushes the PWM carrier
  // and its sidebands above the audible range so the gimbal motor stops whining
  // under load. RP2040 has plenty of PWM headroom for this.
  driver.pwm_frequency = MOTOR_PWM_FREQUENCY;
  driver.voltage_power_supply = 5;
  driver.voltage_limit = 5;
  driver.init();

  encoder.init();
  encoder.enableInterrupts(doA, doB);
  motor.linkSensor(&encoder);

  driver.voltage_power_supply = 5;
  driver.init();

  motor.linkDriver(&driver);
  motor.voltage_sensor_align = 3;

  motor.PID_velocity.D = 0;

  motor.voltage_limit = MOTOR_BASE_VOLTAGE_LIMIT;

  motor.PID_velocity.output_ramp = 1000;
  motor.LPF_velocity.Tf = 0.025f;//0.01f;
  motor.P_angle.P = 20;
  motor.velocity_limit = 4;

  motor.init();
  motor.initFOC();

  Serial.begin(115200);
  if(debug){
    while(!Serial){}
  }
  Serial.println("Motor ready!");
  FOC_Ready = true;
}

void setup1(){ //core 1
  usb_keyboard.begin();
  usb_mouse.begin();

  FastLED.addLeds<WS2812, DATA_PIN, GRB>(leds, NUM_LEDS);

  SPI.setRX(_MISO);
  SPI.setTX(_MOSI);
  SPI.setSCK(_SCK);

  if(debug){
    while(!Serial){}
  }

  initialiseSD();
  setupUsbStorage();

  loadSettings("/config.xml");
  readLastState();

  applyLedMode(ledMode);

  u8g2.begin();

  for(int i = 0; i < buttonCount; i++){
    pinMode(buttonPins[i], INPUT_PULLUP);
    buttonRawState[i] = 0;
    buttonDebounceTimer[i] = millis();
  }
  buttonsReady = true; //core 0 may start sampling now that the pins are pulled up

  noteActivity(); //start the sleep timeout from a booted pad, not from millis() 0

  while(!FOC_Ready){delay(10);}
}

// True when the given domain turns wheel ticks into its own output rather than
// leaving them as a mouse scroll. That output is a key tap for every direction
// action except WHEEL_KEY_SERIAL_SCRATCH, which is reported over serial.
bool wheelDomainSendsKeys(int8_t domain){
  if(domain < 0 || domain >= 6 || buttonWheelMode[domain] == WHEEL_DOMAIN_NONE){
    return false;
  }
  return buttonWheelUp[domain] != 0 || buttonWheelDown[domain] != 0;
}

// Points the wheel at a button's domain, or back at the profile default when
// handed anything that is not a domain button.
void setWheelDomain(int8_t domain){
  if(domain >= 0 && domain < 6 && buttonWheelMode[domain] != WHEEL_DOMAIN_NONE){
    activeWheelDomain = domain;
    wheelMode = buttonWheelMode[domain];
    // A domain that taps its own keys must not also hold the profile's wheel
    // key down, it is not scrolling at all.
    wheelAction = wheelDomainSendsKeys(domain) ? 0 : profileWheelKey;
  } else {
    activeWheelDomain = -1;
    wheelMode = profileWheelMode;
    wheelAction = profileWheelKey;
  }

  wheelModeChanged = true; //core 0 rebuilds the haptic model for the new mode
}

void clearWheelDomain(){
  if(activeWheelDomain >= 0){
    setWheelDomain(-1);
  }
}

// Press a domain button: switch to it, or back to the profile default when it
// is the one already running.
void toggleWheelDomain(int8_t domain){
  setWheelDomain(activeWheelDomain == domain ? -1 : domain);
}

// Samples the pins and folds the bounce out of them. A reading only becomes the
// button's state once it has stayed put for BUTTON_DEBOUNCE_MS, so the chatter
// at both the press and the release is swallowed here instead of turning into
// double actions further down.
//
// This runs on core 0 rather than alongside the rest of buttonRead() on core 1
// on purpose: core 1 only comes round once per display frame, which is tens of
// milliseconds, and a debounce window is worth nothing if it is shorter than
// the gap between samples. Core 0 is the FOC loop and comes round in
// microseconds, so every button gets sampled hundreds of times per window and a
// short press can no longer fall between two readings either.
void buttonDebounce(){
  if(!buttonsReady){
    return; //pull ups not configured yet, the pins would read as pressed
  }

  unsigned long now = millis();

  for(int i = 0; i < buttonCount; i++){
    int raw = !digitalRead(buttonPins[i]);

    if(raw != buttonRawState[i]){
      buttonRawState[i] = raw;
      buttonDebounceTimer[i] = now; //still moving, start the window again
      continue;
    }

    if(raw == lastButtonState[i] || now - buttonDebounceTimer[i] < BUTTON_DEBOUNCE_MS){
      continue;
    }

    lastButtonState[i] = raw;
    lastActivityTime = now; //holds the sleep timeout off, see sleep.ino

    if(raw){
      buttonPressStart[i] = now;
      if(sleepActive){
        // Latched rather than acted on here: waking touches the display and the
        // LEDs, both of which belong to core 1.
        sleepWakeRequest = true;
      }
    } else {
      // Released for real. Edge triggered actions are armed again from here,
      // which is what keeps a bouncing release from arming a second press.
      menuButtonHandled[i] = false;
      if(i < 6){
        domainButtonHandled[i] = false;
        macroButtonHandled[i] = false;
      }
    }
  }
}

void buttonRead(){ //Act on the debounced button states.
  // A sleeping pad does nothing but wake up. The press that wakes it is not
  // passed on, so the first touch after a break never fires a macro or steps
  // the profile by accident.
  if(sleepActive){
    if(sleepWakeRequest || anyButtonDown()){
      wakeFromSleep();
    }
    return;
  }

  if(sleepWakeGuard){
    if(anyButtonDown()){
      return; //still holding whatever woke it
    }
    sleepWakeGuard = false;
    // Everything edge triggered was re armed by buttonDebounce() on the release
    // that just happened, so the next press is a normal one.
  }

  if(usbStorageMode){
    if(lastButtonState[6] && lastButtonState[7]){
      if(usbStorageButtonTimer == 0){
        usbStorageButtonTimer = millis();
      } else if(usbStorageButtonTimer + 2000 < millis()){
        exitUsbStorageMode();
      }
    } else {
      usbStorageButtonTimer = 0;
    }
    return;
  }

  if(profileSelectMenu){
    handleMenuButtons();
  }

  // avoid immediate re-entry after closing menu until both buttons are released
  if(menuReentryGuard){
    if(!lastButtonState[6] && !lastButtonState[7]){
      menuReentryGuard = false;
    }
  }

  if(sdDetected && !profileSelectMenu){
    for(int i = 0; i < 6; i++){
      if(buttonWheelMode[i] != WHEEL_DOMAIN_NONE){
        // Wheel domain button: it only ever switches the wheel over, its macro
        // actions are ignored. Edge triggered so a held button toggles once.
        // The press edge is already debounced, so nothing else is needed to
        // keep a bouncing contact from toggling the domain twice.
        if(lastButtonState[i] && !domainButtonHandled[i]){
          domainButtonHandled[i] = true;
          toggleWheelDomain((int8_t)i);
        }
        continue;
      }

      if(lastButtonState[i] && !macroButtonHandled[i]){
        macroButtonHandled[i] = true;
        macroOutput(i);
        keyPressed = true;
        keyTimer = millis();
      }
    }
    if(!menuReentryGuard && lastButtonState[6]){ //Next Profile
      if(!profilePlusStarted){
        profilePlusStarted = true;
        profileChangeTimer = millis();
      }
      if(profilePlusStarted && profileChangeTimer + 800 < millis()){
        openMenu();
      }
    } else {
      if(profilePlusStarted){
        if(activeProfile < totalProfiles - 1){
          activeProfile++;
          loadProfile("/config.xml", activeProfile);
          storeLastProfile();
          Serial.print("Stored last profile = ");
          Serial.println(activeProfile);
          loadButtonIcons();
          delay(100);
        }
      }
    }
    if(!menuReentryGuard && lastButtonState[7]){ //Previous Profile
      if(!profileMinusStarted){
        profileMinusStarted = true;
        profileChangeTimer = millis();
      } else if(profileMinusStarted && profileChangeTimer + 800 < millis()){
        openMenu();
      }
    } else {
      if(profileMinusStarted){
        if(activeProfile > 0 ){
          activeProfile--;
          loadProfile("/config.xml", activeProfile);
          storeLastProfile();
          Serial.print("Stored last profile = ");
          Serial.println(activeProfile);
          loadButtonIcons();
          delay(100);
        }
      }
    }
    if(!lastButtonState[7] && !lastButtonState[6]){
      profileMinusStarted = false;
      profilePlusStarted = false;
    }
  } else if(!sdDetected && !profileSelectMenu){
    if(lastButtonState[4]){
      initialiseSD();
      delay(100);
    }

  }

  if(keyPressed && keyTimer + 50 < millis()){
    usb_keyboard.keyboardRelease(REPORT_ID_KEYBOARD);
    keyPressed = false;
  }
}

void initialiseSD(){
  SD.end(true); //Attempt to close any previous SD sessions

  if (!SD.begin(_CS)) {
    Serial.println("initialization failed!");
    return;
  } else {
    sdDetected = true;
    Serial.println("SD Initialised!");
  }

  totalProfiles = countProfiles("/config.xml");
  if(debug){
    Serial.print("Profiles found: ");
    Serial.println(totalProfiles);
  }

  activeProfile = readLastProfile();
  Serial.print("Active Profile = ");
  Serial.println(activeProfile);

  loadProfile("/config.xml", activeProfile);
  loadButtonIcons();
}

void setupUsbStorage(){
  usb_msc.setID("CNCDan", "HapticPad SD", "1.0");
  usb_msc.setReadWriteCallback(usbStorageReadCb, usbStorageWriteCb, usbStorageFlushCb);
  // Set a safe default; real capacity is updated when entering storage mode
  usb_msc.setCapacity(usbStorageBlockCount == 0 ? 8 : usbStorageBlockCount, 512);
  usb_msc.setUnitReady(false);
  usb_msc.begin();
}

bool enterUsbStorageMode(){
  if(usbStorageMode){
    return true;
  }

  storeLastState();
  SD.end(true);
  delay(5);

  if(!usbStorageFat.begin(usbStorageConfig)){
    initialiseSD();
    return false;
  }

  if(usbStorageBlockCount == 0 && usbStorageFat.card()){
    usbStorageBlockCount = usbStorageFat.card()->sectorCount();
  }

  if(usbStorageBlockCount == 0){
    if(usbStorageFat.card()){
      usbStorageFat.card()->syncDevice();
    }
    initialiseSD();
    return false;
  }

  usb_msc.setCapacity(usbStorageBlockCount, 512);
  usb_msc.setUnitReady(true);
  TinyUSBDevice.detach();
  delay(30);
  TinyUSBDevice.attach();
  usbStorageMode = true;
  sdDetected = false;
  hapticTestActive = false;
  clearWheelDomain();
  profileSelectMenu = false;
  menuPage = MENU_NONE;
  currentMenu = nullptr;
  return true;
}

void exitUsbStorageMode(){
  if(!usbStorageMode){
    return;
  }

  usb_msc.setUnitReady(false);
  usbStorageMode = false;
  usbStorageButtonTimer = 0;
  if(usbStorageFat.card()){
    usbStorageFat.card()->syncDevice();
  }

  initialiseSD();
  totalProfiles = countProfiles("/config.xml");
  if(activeProfile >= (int)totalProfiles){
    activeProfile = totalProfiles > 0 ? (int)totalProfiles - 1 : 0;
  }
  loadSettings("/config.xml");
  loadProfile("/config.xml", activeProfile);
  loadButtonIcons();
}

void loop() {
  motor.loopFOC();

  // Buttons are sampled from here so the debounce window is many samples wide,
  // see buttonDebounce(). Core 1 only acts on the result.
  buttonDebounce();

  // Wheel domain output is drained from here as well, one report at a time, so
  // a run of key taps never stalls the FOC loop. It runs before the storage
  // mode check so a key that is still down when the pad turns into a card
  // reader is let go of first.
  wheelTapTick();

  // The serial scratch delta goes out from here too, and for the same reason:
  // this is the core that owns Serial, and one short batched write per 20 ms is
  // all the FOC loop can afford.
  serialScratchTick();

  if(usbStorageMode){
    lastWheelMode = -1; //re-initialise the wheel when storage mode ends
    return;
  }

  // Work out which behaviour the wheel should be running right now. The haptic
  // test page overrides the profile, and an open menu overrides both.
  int effectiveMode;
  if(hapticTestActive){
    effectiveMode = hapticTestMode;
  } else if(profileSelectMenu){
    effectiveMode = WHEEL_MODE_MENU;
  } else {
    effectiveMode = wheelMode;
  }

  if(lastWheelMode != effectiveMode){
    wheelModeChanged = true;
  }
  lastWheelMode = effectiveMode;

  switch (effectiveMode)
  {
  case WHEEL_MODE_MENU:
    menuWheel(); // menu navigation only, no PC scroll
    break;
  case WHEEL_CLICKY:
    notchyWheel();
    break;
  case WHEEL_TWIST:
    twistScroll();
    break;
  case WHEEL_MOMENTUM:
    freeSpinning();
    break;
  case WHEEL_FREE_SCROLL:
    freeScroll();
    break;
  case WHEEL_ENDSTOP:
    endstopWheel();
    break;
  case WHEEL_FRICTION:
    frictionWheel();
    break;
  case WHEEL_SNAP:
    snapWheel();
    break;
  case WHEEL_MAGNETIC:
    magneticWheel();
    break;

  default:
    break;
  }
}

void resetLedAnimationState(){
  sequenceStep = 0;
  haloCount = 0;
  breathIncrease = true;
  evenNumber = false;
  loopCounter = 0;
  ledTimer = millis();
}

void applyLedMode(uint8_t mode){
  if(mode >= LED_MODE_COUNT){
    mode = LED_MODE_COUNT - 1;
  }
  ledMode = mode;
  calculateColourMultiplier();
  rgbMenuSelection = findLedMenuIndex(ledMode);
  resetLedAnimationState();
}

uint8_t rootMenuCount(){
  return 5;
}

uint8_t profileMenuCount(){
  return totalProfiles > 255 ? 255 : (uint8_t)totalProfiles;
}

uint8_t rgbMenuCount(){
  return ledModeMenuCount;
}

uint8_t colorMenuCount(){
  return 2;
}

uint8_t hapticMenuCount(){
  return WHEEL_MODE_COUNT;
}

void enterRootMenu(){
  menuRootSelection = 0;
}

void enterProfileMenu(){
  if(totalProfiles == 0){
    profileMenuSelection = 0;
    return;
  }
  if(activeProfile < (int)totalProfiles){
    profileMenuSelection = activeProfile;
  } else {
    profileMenuSelection = totalProfiles - 1;
  }
}

void enterRGBMenu(){
  rgbMenuSelection = findLedMenuIndex(ledMode);
}

void enterColorMenu(){
  colorMenuSelection = 0;
  colorEditActive = false;
  colorEditChannel = 0;
  colorEditSelection = 0;
  colorEditPtr = nullptr;
}

void enterHapticMenu(){
  hapticTestActive = false;
  if(hapticMenuSelection >= WHEEL_MODE_COUNT){
    hapticMenuSelection = 0;
  }
}

void confirmRoot(uint8_t selection){
  switch (selection)
  {
  case 0:
    enterMenu(MENU_PROFILE);
    break;
  case 1:
    enterMenu(MENU_RGB);
    break;
  case 2:
    enterMenu(MENU_COLOR);
    break;
  case 3:
    toggleUsbStorageMode();
    break;
  case 4:
    enterMenu(MENU_HAPTIC);
    break;
  default:
    break;
  }
}

void confirmHaptic(uint8_t selection){
  if(selection >= WHEEL_MODE_COUNT){
    return;
  }

  hapticTestMode = selection;
  hapticTestActive = true; //core 0 picks this up and runs the mode without any output
}

void confirmProfile(uint8_t selection){
  applyProfileSelection(selection);
}

void confirmRGB(uint8_t selection){
  applyLedSelection(selection);
}

void confirmColor(uint8_t selection){
  colorEditSelection = selection;
  colorEditChannel = 0;
  colorEditActive = true;
  colorEditPtr = (selection == 0) ? primaryColour : secondaryColour;
  colorDirty = false;
}

const MenuDefinition menuDefinitions[] = {
  {MENU_ROOT, MENU_NONE, &menuRootSelection, rootMenuCount, drawRootMenu, confirmRoot, enterRootMenu},
  {MENU_PROFILE, MENU_ROOT, &profileMenuSelection, profileMenuCount, drawProfileMenu, confirmProfile, enterProfileMenu},
  {MENU_RGB, MENU_ROOT, &rgbMenuSelection, rgbMenuCount, drawRGBMenu, confirmRGB, enterRGBMenu},
  {MENU_COLOR, MENU_ROOT, &colorMenuSelection, colorMenuCount, drawColorMenu, confirmColor, enterColorMenu },
  {MENU_HAPTIC, MENU_ROOT, &hapticMenuSelection, hapticMenuCount, drawHapticMenu, confirmHaptic, enterHapticMenu}
};

const MenuDefinition* getMenuDefinition(MenuPage page){
  for(size_t i = 0; i < sizeof(menuDefinitions)/sizeof(menuDefinitions[0]); i++){
    if(menuDefinitions[i].id == page){
      return &menuDefinitions[i];
    }
  }
  return nullptr;
}

void clampMenuSelection(const MenuDefinition *menu){
  if(!menu || !menu->selection || !menu->countFn){
    return;
  }

  uint8_t count = menu->countFn();
  if(count == 0){
    *menu->selection = 0;
    return;
  }

  if(*menu->selection >= count){
    *menu->selection = count - 1;
  }
}

void enterMenu(MenuPage page){
  currentMenu = getMenuDefinition(page);
  menuPage = page;

  if(currentMenu && currentMenu->enterFn){
    currentMenu->enterFn();
  }

  clampMenuSelection(currentMenu);
}

void menuScroll(int8_t scroll){
  if(!currentMenu || scroll == 0 || hapticTestActive){
    return;
  }

  if(menuPage == MENU_COLOR && colorEditActive && colorEditPtr){
    int8_t delta = (scroll < 0) ? 5 : -5; //wheel direction mapped to +/-
    int16_t value = colorEditPtr[colorEditChannel] + delta;
    value = constrain(value, 0, 255);
    colorEditPtr[colorEditChannel] = (uint8_t)value;
    calculateColourMultiplier();
    colorDirty = true;
    return;
  }

  uint8_t count = currentMenu->countFn ? currentMenu->countFn() : 0;
  if(count == 0){
    return;
  }

  int16_t selection = *currentMenu->selection;
  selection += (scroll < 0 ? 1 : -1);
  selection = constrain(selection, 0, count - 1);
  *currentMenu->selection = (uint8_t)selection;
}

void menuHandleConfirm(){
  if(hapticTestActive){
    return; //already running a test, BACK is the only way out
  }

  if(menuPage == MENU_COLOR && colorEditActive){
    colorEditChannel = (colorEditChannel + 1) % 3; //cycle R,G,B
    return;
  }

  if(currentMenu && currentMenu->confirmFn){
    currentMenu->confirmFn(*currentMenu->selection);
  }
}

void menuHandleBack(){
  if(hapticTestActive){
    hapticTestActive = false; //stop the test, back to the mode list
    return;
  }

  if(menuPage == MENU_COLOR && colorEditActive){
    if(colorDirty){
      storeLastState();
      colorDirty = false;
    }
    colorEditActive = false;
    colorEditChannel = 0;
    colorEditPtr = nullptr;
    return;
  }

  if(menuPage == MENU_ROOT || !currentMenu || currentMenu->parent == MENU_NONE){
    exitMenu();
  } else {
    enterMenu(currentMenu->parent);
  }
}

void renderCurrentMenu(){
  if(currentMenu && currentMenu->renderFn){
    currentMenu->renderFn(*currentMenu->selection);
  }
}

void openMenu(){
  hapticTestActive = false;
  clearWheelDomain(); //the menu owns the wheel, and it is gone on the way out
  profileSelectMenu = true;
  profilePlusStarted = false;
  profileMinusStarted = false;
  menuButtonHandled[6] = true; //ignore current press that opened the menu
  menuButtonHandled[7] = true;
  enterMenu(MENU_ROOT);
  // Makes core 0 pick the menu up and build the Clicky model for it. The wheel
  // position itself does not need seeding, menuWheel() centres the detents on
  // wherever the wheel happens to be sitting.
  wheelModeChanged = true;
}

void exitMenu(){
  hapticTestActive = false;
  profileSelectMenu = false;
  menuPage = MENU_NONE;
  currentMenu = nullptr;
  if(colorDirty){
    storeLastState();
    colorDirty = false;
  }
  colorEditActive = false;
  colorEditChannel = 0;
  colorEditPtr = nullptr;
  profileMinusStarted = false;
  profilePlusStarted = false;
  menuReentryGuard = true; //wait for release before allowing menu again
  wheelModeChanged = true;
}

void applyProfileSelection(uint8_t selection){
  if(totalProfiles == 0){
    exitMenu();
    return;
  }

  if(selection >= totalProfiles){
    selection = totalProfiles - 1;
  }

  activeProfile = selection;
  loadProfile("/config.xml", activeProfile);
  storeLastProfile();
  Serial.print("Stored last profile = ");
  Serial.println(activeProfile);
  loadButtonIcons();
  exitMenu();
}

void applyLedSelection(uint8_t selection){
  if(ledModeMenuCount == 0){
    return;
  }

  if(selection >= ledModeMenuCount){
    selection = 0;
  }

  rgbMenuSelection = selection;
  uint8_t selectedMode = ledModeMenu[selection];
  applyLedMode(selectedMode);
  storeLastState();
  exitMenu();
}

void toggleUsbStorageMode(){
  if(usbStorageMode){
    exitUsbStorageMode();
  } else {
    enterUsbStorageMode();
  }
}

void handleMenuButtons(){
  // Button 6 = confirm/enter
  if(lastButtonState[6] && !menuButtonHandled[6]){
    menuButtonHandled[6] = true;
    menuHandleConfirm();
  }

  // Button 7 = back/exit
  if(lastButtonState[7] && !menuButtonHandled[7]){
    menuButtonHandled[7] = true;
    menuHandleBack();
  }
}

uint16_t convertConsumerKeycode(int input){
  switch(input){
    case 173:
      return HID_USAGE_CONSUMER_MUTE;
    case 174:
      return HID_USAGE_CONSUMER_VOLUME_DECREMENT;
    case 175:
      return HID_USAGE_CONSUMER_VOLUME_INCREMENT;
    case 176:
      return HID_USAGE_CONSUMER_PLAY;
    case 177:
      return HID_USAGE_CONSUMER_PAUSE;
    case 179:
      return HID_USAGE_CONSUMER_FAST_FORWARD;
    case 180:
      return HID_USAGE_CONSUMER_REWIND;
    case 181:
      return HID_USAGE_CONSUMER_SCAN_NEXT_TRACK;
    case 182:
      return HID_USAGE_CONSUMER_SCAN_PREVIOUS_TRACK;
    case 183:
      return HID_USAGE_CONSUMER_STOP;
    case 184:
      return HID_USAGE_CONSUMER_BRIGHTNESS_INCREMENT;
    case 185:
      return HID_USAGE_CONSUMER_BRIGHTNESS_DECREMENT;
    case 205:
      return HID_USAGE_CONSUMER_PLAY_PAUSE;
  }
  return 0;
}

// Waits for the HID endpoint to drain before the next report is queued.
// TinyUSB drops a report while the previous one is still waiting to be polled,
// so a report sent without this can simply vanish. Bounded, so a pad that is
// powered but not enumerated does not sit here forever.
#define HID_READY_TIMEOUT_MS 20
bool hidWaitReady(){
  unsigned long start = millis();

  while(!usb_keyboard.ready()){
    if(millis() - start > HID_READY_TIMEOUT_MS){
      return false;
    }
  }

  return true;
}

void sendConsumerKey(uint16_t usage){
  uint16_t report = usage;
  usb_keyboard.sendReport(REPORT_ID_CONSUMER, &report, sizeof(report));
  delay(5);
  report = 0;
  usb_keyboard.sendReport(REPORT_ID_CONSUMER, &report, sizeof(report));
}

void macroOutput(int button){
  uint8_t keycode[6] = { 0 };
  int modifier = 0;
        
  for(int i = 0; i < 3; i++){
    delay(macroDelay[button][i]);
    if(macroAction[button][i] != 0){
      uint16_t consumer = convertConsumerKeycode(macroAction[button][i]);
      if(consumer != 0){
        sendConsumerKey(consumer);
        continue;
      }

      keycode[0] = convertKeycode(macroAction[button][i]);
      if(checkModifiers(macroAction[button][i]) != 0){
        modifier = checkModifiers(macroAction[button][i]);
        Serial.println("Modifier Detected");
      } else {
        usb_keyboard.keyboardReport(REPORT_ID_KEYBOARD, modifier, keycode);
      }
    }
  }
}

void loop1() {
  buttonRead();
  sleepTick();

  if(usbStorageMode){
    TinyUSBDevice.task();
    if(sleepActive){
      delay(20);
      return; //keep servicing USB, just do not light anything up
    }
    u8g2.firstPage();
    do {
      drawUsbStorageScreen();
    } while ( u8g2.nextPage() );
    delay(20);
    return;
  }

  if(sleepActive){
    delay(20); //nothing to draw, and core 1 has no reason to spin flat out
    return;
  }

  u8g2.firstPage();
  if(ledTimer + ledSpeed < millis()){
    if(ledMode == 0){
      haloLED();
    } else if(ledMode == 1){
      breathLED();
    } else if(ledMode == 2){
      ledBand();
    } else if(ledMode == 3){
      rainbowLED();
    } else if(ledMode == 4){
      solidLED();
    } else {
      offLED();
    }
    ledTimer = millis();
  }
  
  do {
    if(sdDetected){
      if(!profileSelectMenu){
        drawGrid();
        drawActiveProfile();
      } else {
        renderCurrentMenu();
      }

      // Momentum is the one mode whose scrolling happens on core 1. Keep the
      // reading in a local: the shared encoderAngle global belongs to the core 0
      // wheel modes and clobbering it from here races against them.
      if(!profileSelectMenu && !hapticTestActive && wheelMode == WHEEL_MOMENTUM){
        float momentumAngle = encoder.getAngle();

        if(abs(lastEncoderAngle - momentumAngle) > 0.1){
          wheelScrollOutput((int)((lastEncoderAngle - momentumAngle) * WHEEL_TICKS_PER_RADIAN));
          lastEncoderAngle = momentumAngle;
        } else {
          cancelWheelAction();
        }
      }
    } else {
      u8g2.drawXBMP(59, 10, 10, 13, SD_Card);
      u8g2.setFont(u8g2_font_5x7_tf);
      u8g2.drawStr(17, 36, "No SD Card Detected!");
      u8g2.drawStr(53, 60, "Retry");
    }

  } while ( u8g2.nextPage() );
}

bool storeLastProfile(){
  SD.remove("/lastProfile");

  File file = SD.open("/lastProfile", FILE_WRITE);
  if (file) {
    file.print(activeProfile);
    file.close();
    return true;
  } else {
    return false;
  }
}

int readLastProfile(){
  File file = SD.open("/lastProfile");

  if (!file){
    return 0;
  }

  return (uint8_t)file.parseInt();
}

bool storeLastState(){
  SD.remove("/lastState");

  File file = SD.open("/lastState", FILE_WRITE);
  if(file){
    // Always the profile's own mode, never whichever domain happens to be up.
    file.print(profileWheelMode); file.print(",");
    file.print(ledMode); file.print(",");
    file.print(primaryColour[0]); file.print(",");
    file.print(primaryColour[1]); file.print(",");
    file.print(primaryColour[2]); file.print(",");
    file.print(secondaryColour[0]); file.print(",");
    file.print(secondaryColour[1]); file.print(",");
    file.print(secondaryColour[2]);
    file.close();
    return true;
  }
  return false;
}

bool readLastState(){
  File file = SD.open("/lastState");

  if(!file){
    return false;
  }

  wheelMode = (uint8_t)file.parseInt();
  ledMode = (uint8_t)file.parseInt();
  primaryColour[0] = (uint8_t)file.parseInt();
  primaryColour[1] = (uint8_t)file.parseInt();
  primaryColour[2] = (uint8_t)file.parseInt();
  secondaryColour[0] = (uint8_t)file.parseInt();
  secondaryColour[1] = (uint8_t)file.parseInt();
  secondaryColour[2] = (uint8_t)file.parseInt();

  file.close();

  if(wheelMode < 0 || wheelMode >= WHEEL_MODE_COUNT){
    wheelMode = WHEEL_CLICKY;
  }
  // The restored mode becomes the profile default, and no domain is up yet.
  profileWheelMode = (uint8_t)wheelMode;
  activeWheelDomain = -1;
  if(ledMode >= LED_MODE_COUNT){
    ledMode = LED_MODE_COUNT - 1;
  }

  wheelModeChanged = true; //core 0 started before this ran, make it re-read the mode

  return true;
}
