JonBuhl/Hapticpad/(commit log)

2026-01-09 Added STL's
    [Custom Keycap.STL, Encoder Mount.STL, LED Diffuser Ring.STL, Macro Pad - Printed Version.STL, Macro Pad Magnetic Jog Wheel.STL, Macropad Bottom Cover.STL, Magnet Holder.STL, Magnet Wheel Mount.STL]
2026-01-09 Updated Motor Assembly Drawing
2026-01-09 Added .STEP files
    [Custom Keycap - Machined.STEP, Macro Pad Jog Wheel Machined.STEP, Macro Pad Machined.STEP, Menu Button - Machined.STEP]
2026-01-10 Added PCB's
    [MacroPad Controller Board.kicad_pcb, MacroPad Controller Board.kicad_sch, MacroPad.kicad_pcb, MacroPad.kicad_sch]
2026-01-13 Update tactile button information in README
    Added alternative tactile button options and shipping note.
2026-01-13 Fix typo in README for alternative tactile buttons
2026-02-04 Refactor state management for LED mode and color settings; update menu scrolling behavior
2026-02-04 Update notchyWheel function to disable motor during profile selection menu
2026-02-04 Add free scroll mode and update wheel mode parsing logic
2026-02-08 Refactor HID report handling and add consumer key support for wheel actions
2026-08-20 feat(haptics): add SmartKnob-style torque haptic engine
    Software-defined virtual detents, endstops, snap and magnetic (sparse)
    detents, modelled on scottbez1/smartknob. The motor runs in torque mode
    and a haptic model drives it from the encoder frame, so position counting
    is independent of FOC calibration. Parameters are configurable via
    <Settings> in config.xml.
    [haptics.h, haptics.ino]
2026-08-20 feat(wheel): add Endstop/Friction/Snap/Magnetic modes, Clicky menu navigation, and Haptic Test page
    Four new wheel modes join Clicky/Twist/Momentum/Free. The menu now
    navigates with Clicky haptic detents (one click = one entry) and a new
    'Haptic Test' page runs any mode on the motor with scroll/key output
    suppressed.
    [MacroPad.ino, display.ino, wheel.ino]
2026-08-20 feat(config): haptic settings, new wheel mode names, and docs
    Adds optional haptic <Settings> tags with sensible defaults (backward
    compatible - old config files keep working) and documents the eight wheel
    modes and the haptic test page in README.
2026-08-20 feat(config): example profiles for all 8 wheel modes
    Replace the placeholder profiles with one sensible profile per wheel
    mode (Clicky/Twist/Momentum/Free/Endstop/Friction/Snap/Magnetic),
    each with 6 macro buttons and a matching use case. Fix the file to
    valid YAML by switching buttons to block style (the previous inline
    format did not parse).
    [config.yaml]
2026-08-20 chore(config): regenerate config.xml from config.yaml
    Keep the firmware's XML config in sync with the YAML source: replace
    the placeholder profiles with the 8-mode profiles (one per wheel
    mode) and fix LED_Mode to "Solid", the only value ledModeNames
    actually recognizes ("Static" silently fell back to Off).
2026-08-20 feat(config): profile icons and example SD card config
    Add 48 generated 15x15 1bpp BMP icons (8 profile folders, 6 buttons
    each) for the wheel-mode profiles and sync Example SD Card/config.xml
    byte-identical with the root config.
2026-08-21 wip: media wheel domains (volume/scratch/transport) pre-fix checkpoint
    [MacroPad.ino, config.yaml, display.ino, haptics.h, wheel.ino, xmlData.ino]
2026-08-21 fix(wheel): scratch symmetry via hold-time debt + tap queue, core0 button debounce
    - Wheel domain taps are queued and drained one report per loop() pass only
    when the HID endpoint is ready; press+delay(5)+release per detent lost
    reports inside one polling interval and drifted with wheel speed.
    - FF/RW (179/180) are scan keys: a domain sending them buys hold time per
    detent (scratchDebtMs), so equal detents in both directions buy equal
    scanning and the account always drains to zero. No more track skips via
    rapid tap runs (SCRATCH_DIRECTION_GAP_MS).
    - Buttons debounced on core 0 (25ms stability, both edges, all 8 pins)
    instead of the old 150ms global toggle barrier on core 1 that c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
    [MacroPad.ino, haptics.h, wheel.ino]
2026-08-21 fix(buttons): fire macros on press edge only, not every display frame
    A held macro button re-sent its macro on every loop1() pass, so a single
    press of a toggle key (Play/Pause) toggled several times. Macro buttons
    now use the same handled-on-press-edge/rearm-on-release pattern as the
    wheel domain buttons.
    [MacroPad.ino]
2026-08-21 fix(wheel): force Friction haptics for scan domains, never swallow ticks at a stop
    The Scratch domain used the Endstop haptic mode, which has only
    Haptic_Range (24) positions. Ticks past the stop were dropped and never
    came back on the reverse turn, so repeated forward scratching drifted the
    debt account past the song start. Scan domains now always run the
    unbounded continuous Friction model, so every tick reaches the debt
    account and forward/backward scratching is exactly symmetric.
    [MacroPad.ino, config.yaml]
2026-08-21 feat(wheel): wheelMod modifier support, Scratch uses Shift+Arrow (Spotify 5s seek)
    Spotify Desktop's media keys only seek in fixed 10s steps; Shift+Arrow
    seeks 5s (app needs focus). Domains can now declare an optional wheelMod
    that is sent together with wheelUp/wheelDown in one HID report, and the
    Scratch domain is configured to 39/37 with Shift (16). Generator and XML
    parser handle the new tag.
    [MacroPad.ino, config.yaml, wheel.ino, xmlData.ino]
2026-08-21 Revert "feat(wheel): wheelMod modifier support, Scratch uses Shift+Arrow (Spotify 5s seek)"
    This reverts commit 5ea72f5f13caefd6f538024b1165064d11ad8e17.
    [MacroPad.ino, config.yaml, wheel.ino, xmlData.ino]
2026-08-21 feat(config): System profile with brightness wheel + OS shortcuts, add 184/185/44 keycodes
    Profil 10 'System': Button 1 = Helligkeit (Endstop, Consumer-Brightness
    184/185), Buttons 2-6 = Screenshot (44), Alt+Tab, Activities (Super),
    Lock (Super+L), Area Shot (Shift+Druck) — GNOME/CachyOS shortcuts.
    Firmware: convertConsumerKeycode 184/185 -> BRIGHTNESS_INC/DEC,
    convertKeycode 44 -> PRINT_SCREEN.
    [MacroPad.ino, config.yaml, keyCodes.ino]
2026-08-21 feat: remove scratch mechanic entirely, keep volume + brightness domains
    Scratch domain, scan-key hold-time account, SCRATCH_* constants,
    scratchSeekTick/isScanKey/wheelDomainScans and the Friction override in
    setWheelDomain are gone. Media profile button 2 is now Stop (183);
    Volume (1) and Play/Pause/Next/Prev/Mute (3-6) unchanged, System profile
    (brightness + OS shortcuts) unchanged. Tap-queue wheel domain mechanic
    stays for Volume/Brightness.
    [MacroPad.ino, config.yaml, haptics.h, wheel.ino]
2026-08-23 feat(config): Hermes desktop app profile
    New 11th profile 'Hermes' mapping the desktop app's Linux shortcuts:
    Esc (stop turn), Ctrl+N (new session tab), Ctrl+K (command palette),
    Ctrl+` (terminal pane), Ctrl+G (git review pane), Ctrl+J (preview
    rail). Clicky wheel for scrolling the chat transcript. Includes
    SD-card button icons.
    [config.yaml]
2026-08-23 fix(haptics): raise PWM carrier to 50 kHz to silence coil whine
    SimpleFOC default (~20 kHz) is audible when the PID pushes holding torque
    under load. 50 kHz moves the carrier above the audible range.
    [MacroPad.ino, haptics.h]
2026-09-07 chore(firmware): version the firmware archive and add first main build
    The firmware/ archive was gitignored, so no built binary was ever kept
    next to the code it came from. The only UF2 in the repo was the upstream
    MacroPad_V1.0.uf2 from January, which predates the whole fork.
    Un-ignore firmware/. Just dropping the /firmware/ line is not enough:
    *.uf2 would still swallow the archived binary, so the exception is
    expressed as explicit negations for *.uf2 and notes.md under firmware/.
    Build artefacts anywhere else stay ignored.
    Add the first build of the current main: flash 174716 B (1%), RAM 28832 B
    (10%), FQBN rp2040:rp2040:waveshare_rp2040_plus with TinyUSB, core 5.5.0.
    Contains the SmartK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
2026-09-07 feat(sleep): smart sleep blanks OLED and LEDs after 5 idle minutes
    A pad left on the desk kept a static screen lit indefinitely, which is the
    worst thing to leave on an OLED, and the LED ring stayed on as a lamp nobody
    asked for.
    After <Sleep_Timeout> minutes with no input the display is switched off via
    u8g2's own power save (the panel's display-off command, not just a cleared
    buffer) and the ring is blacked out. Any button press brings both back.
    Notable details:
    - The press that wakes the pad is swallowed. Without it the first touch after
    a break fired that button's macro, and on the menu buttons it stepped the
    profile on release. A guard blocks buttonRead() until every button is u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
2026-09-07 feat(webui): HapticPad Studio for editing config.xml and icon BMPs
    Adds a local web UI so the config and the OLED icons can be edited without
    hand writing XML or running a one-off Python script per profile.
    Standard library plus Pillow only, no Flask and no npm. Serves on
    127.0.0.1:8765; --sd points the icon tools at a mounted card.
    XML tab: every <Settings> tag with the range validateHapticSettings() would
    clamp it to anyway, the LED modes and their menu order, and a profile editor
    covering all six buttons, three actions each, keycodes by name, and the
    optional per-button wheel domain. Settings are always emitted in
    SETTINGS_ORDER with Sleep_Timeout last, because the firmware searches the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
2026-09-25 feat(wheel): serial scratch domain — detents as S<delta> lines over USB-CDC
    Scratch (keycode 250) sends no HID; a signed detent delta is batched
    every 20ms on core 0 and written as 'S<n>' to Serial. The host daemon
    (hapticpad-scratch) turns it into an absolute MPRIS seek — drift-free by
    construction, real end stops from the player's track length. Media
    profile button 2 is the serial scratch domain again.
    [MacroPad.ino, config.yaml, wheel.ino]
